IdeaZero/Solar_Ribbit_Pro/Electronics/Design/PCB_Image.png

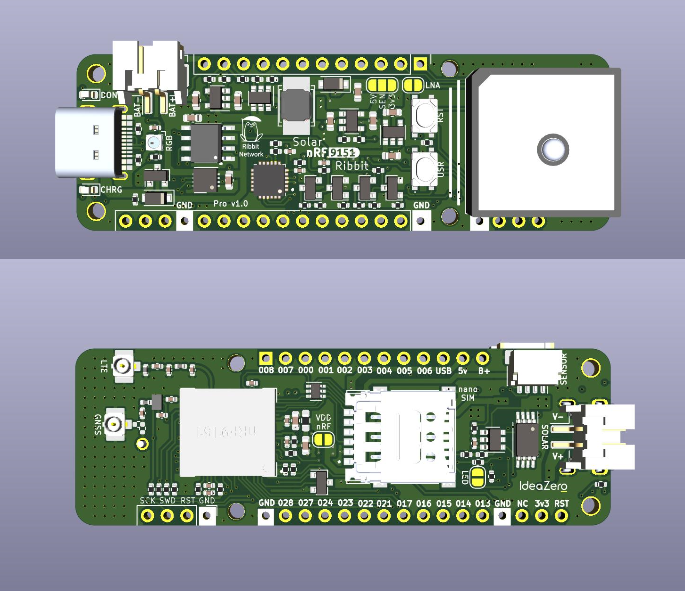
Electronics/Design/PCB_Image.png
