IdeaZero/Solar_Ribbit_Pro/Firmware/hex/Firmware.png

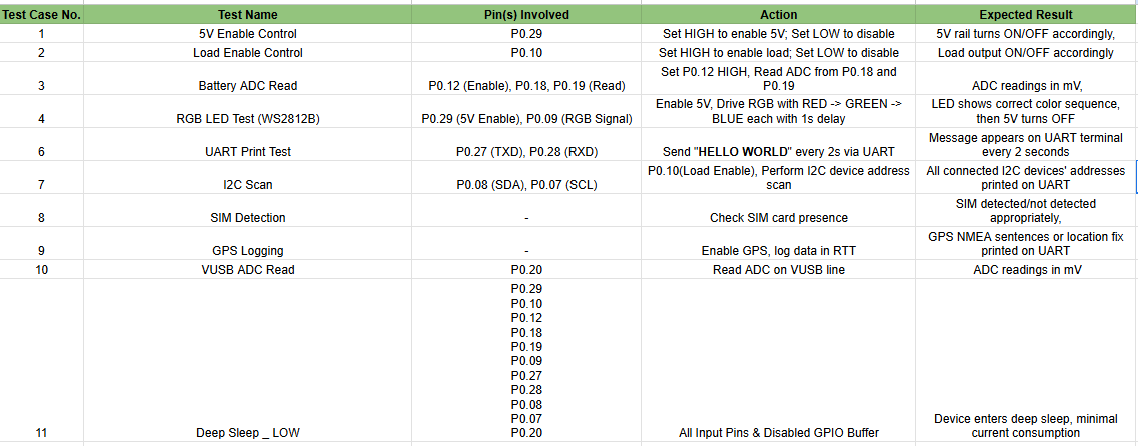
Firmware/hex/Firmware.png
