IdeaZero/Solar_Ribbit_Pro/Electronics/Manufacturing/nRF9151_Linear.kicad_pcb_bom.xlsx

Designator | Quantity | Value | Footprint | MPN | DNP | Mount_Type | Comments
AE1 | 1 | Antenna | YG0005AA | YG0005AA |  | tht
C1, C11, C12, C19, C2, C20, C21, C23, C24, C26, C4 | 11 | 10uF | C_0603_1608Metric | CL10A106MO8NQNC |  | smt
C10, C14, C16, C18, C27, C6, C7 | 7 | 0.1uF | C_0402_1005Metric | CC0402KRX7R7BB104 |  | smt
C13, C9 | 2 | 4.7uF | C_0402_1005Metric | CL05A475MO5NUNC |  | smt
C15, C17 | 2 | NC | C_0402_1005Metric | - | YES | smt
C22 | 1 | 1nF | C_0402_1005Metric | CC0402KRX5R9BB102 |  | smt
C25 | 1 | 3.5pF | C_0402_1005Metric | GRM1555C1H3R5CA01D |  | smt
C3, C5 | 2 | 1uF | C_0402_1005Metric | CL05A105KO5NNNC |  | smt
C8 | 1 | 39pF | C_0402_1005Metric | CC0402JRNPO9BN390 |  | smt
D1, D2 | 2 | SS34 | D_SOD-123F | DSS34 |  | smt
D3 | 1 | DONE | LED_0603_1608Metric | PSC-1608U52GC-G4 |  | smt
D4 | 1 | CHRG | LED_0603_1608Metric | XL-1608SURC-06 |  | smt
D5 | 1 | ESD | SOT-363_SC-70-6 | PSC-1608U52GC-G4 |  | smt
D6 | 1 | RGB | SK6812_2020 | SK6812-EC20 |  | tht
FB1 | 1 | 120R/0.7A | R_0603_1608Metric | FCM1608KF-121T06 |  | smt
IC1 | 1 | BGA524N6E6327XTSA1 | BGA524N6E6327XTSA1 | BGA524N6E6327XTSA1 |  | smt
J1 | 1 | USC-C | USB_TYPE-C-31-M-12_ExtraPad | TYPE-C-31-M-12 |  | tht
J10 | 1 | GPIOXL | PinHeader_1x16_P2.54mm_Vertical | - | YES | tht
J11 | 1 | GPIOXR | PinHeader_1x12_P2.54mm_Vertical | - | YES | tht
J2 | 2 | SOLAR, BAT | JST_PH_B2B-PH-SM4-TB_1x02-1MP_P2.00mm_Vertical | PH-2PWB |  | smt
J4 | 1 | SWD | PinHeader_1x04_P2.54mm_Vertical | - | YES | tht
J5 | 1 | NSIM-2-C | NSIM-2-C | NSIM-2-C |  | smt
J6 | 1 | QWIIC/STEMMA | JST_SH_SM04B-SRSS-TB_1x04-1MP_P1.00mm_Horizontal | 1.0-4PWB |  | smt
J7 | 2 | GNSS, LTE | U.FL-R-SMT-1 | U.FL-R-SMT(10) |  | tht
JP1 | 1 | 5V3 | SolderJumper-3 | - | YES | tht
JP2 | 1 | LED_PWR | SolderJumper-2 | - | YES | tht
JP5 | 1 | VDD_LNA | SolderJumper-2 | - | YES | tht
JP6 | 1 | VDD_nRF | SolderJumper-2 | - | YES | tht
L1 | 1 | 10uH | 5x5 | GPSR0520-100M |  | tht
L2 | 1 | 1.5nH | L_0402_1005Metric | LQG15HS1N5S02D |  | smt
L3 | 1 | 9.1nH | L_0402_1005Metric | LQG15HS9N1J02D |  | smt
L4 | 1 | 22nH | L_0402_1005Metric | LQG15HS22NJ02D |  | smt
Q1, Q3, Q5 | 3 | Si2319CDS | SOT-23 | SI2319CDS |  | smt
Q2, Q4, Q6 | 3 | BSS138 | SOT-23 | BSS138 |  | smt
R1, R13, R14, R26, R29, R31, R34, R40 | 8 | 10K | R_0402_1005Metric | RC0402FR-0710KL |  | smt
R10, R11 | 2 | 5.1K | R_0402_1005Metric | RC0402FR-075K1L |  | smt
R12, R25, R38, R39 | 4 | 1M | R_0402_1005Metric | RC0402FR-071ML |  | smt
R15, R16, R19 | 3 | 1K | R_0402_1005Metric | RC0402FR-071KL |  | smt
R17, R18, R27, R28, R8, R9 | 6 | 0R | R_0402_1005Metric | RC0402JR-070RL |  | smt
R2 | 1 | 22K | R_0402_1005Metric | RC0402FR-0722KL |  | smt
R20, R21, R32, R33 | 4 | 4.7K | R_0402_1005Metric | RC0402FR-074K7L |  | smt
R22, R37 | 2 | 47K | R_0402_1005Metric | RC0402FR-0747KL |  | smt
R23, R35, R36, R4, R5, R7 | 6 | 100K | R_0402_1005Metric | RC0402FR-07100KL |  | smt
R24 | 1 | 13K | R_0402_1005Metric | RC0402FR-0713KL |  | smt
R3 | 1 | 33K | R_0402_1005Metric | RC0402FR-0733KL |  | smt
R41 | 1 | 470R | R_0402_1005Metric | RC0402FR-07470RL |  | smt
R42 | 1 | 100R | R_0402_1005Metric | RC0402FR-07100RL |  | smt
R6 | 1 | 220K | R_0402_1005Metric | RC0402FR-07220KL |  | smt
SW1 | 2 | USER, RESET | SPST_PTS815XX | PTS815SJK250SMTRLFS |  | smt
U1, U10 | 2 | MT9700 | SOT-23-5 | MT9700 |  | smt
U2 | 1 | MT3608L | SOT-23-6 | MT3608L |  | smt
U3 | 1 | CP2102N-A02-GQFN24R | CP2102N-A02-GQFN24R | CP2102N-A02 |  | smt | Optional -- for debugging
U4 | 1 | TP4056_CH | SOP-8 | TP4056 |  | smt
U5 | 1 | CN3165 | DFN-8-1EP_3x3mm_P0.5mm_EP1.66x2.38mm | CN3165 | YES | smt | Optional – Either this or TP4056 – anyone
U6 | 1 | XC6220B331MR-G | SOT-23-5 | XC6220B331MR-G |  | smt
U7 | 1 | DW01_Batt_Protection | SOT-23-6 | DW01 |  | smt
U8 | 1 | FS8205A_Bat_Protection | TSSOP-8_4.4x3mm_P0.65mm | FS8205A |  | smt
U9 | 1 | NRF9151-LACA-R7 | NRF9151-LACA-R7 | NRF9151-LACA-R7 |  | smt
