IdeaZero/Solar_Ribbit_Pro/Mechanical/V4_Holder_3.STL

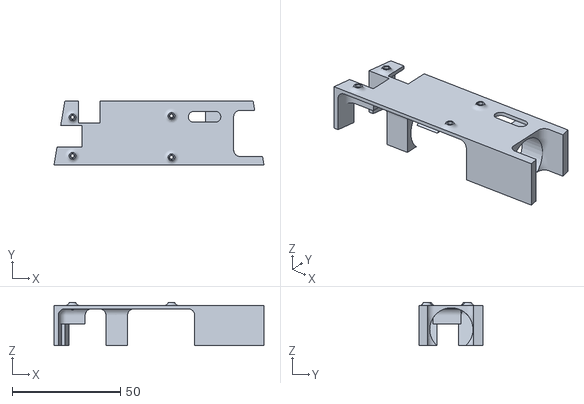
[picture p3: CAD file, 2025-05-09]
Mechanical/V4_Holder_3.STL
97.0 x 29.4 x 20.0
