IdeaZero/Solar_Ribbit_Pro/Firmware/Firmware/led_strip/build/led_strip_sysbuild_cache.txt

APPLICATION_BINARY_DIR:PATH=/home/parth/Desktop/nrf9151/led_strip/build
APPLICATION_SOURCE_DIR:PATH=/home/parth/ncs/v2.8.0/zephyr/share/sysbuild/template
APP_DIR:PATH=/home/parth/Desktop/nrf9151/led_strip
BOARD_DIR:PATH=/home/parth/ncs/v2.8.0/zephyr/boards/nordic/nrf9151dk
BOARD_DIRECTORIES:INTERNAL=/home/parth/ncs/v2.8.0/zephyr/boards/nordic/nrf9151dk
BOARD_EXTENSIONS:BOOL=ON
BOARD_ROOT:PATH=/home/parth/Desktop/nrf9151/led_strip
CACHED_BOARD:STRING=nrf9151dk/nrf9151/ns
CACHED_SHIELD:STRING=
FIND_PACKAGE_MESSAGE_DETAILS_Python3:INTERNAL=[/home/parth/ncs/toolchains/b81a7cd864/usr/local/bin/python3.12][cfound components: Interpreter ][v3.12.4(3.8)]
HWM:INTERNAL=v2
HWMv2:INTERNAL=True
NCS_TOOLCHAIN_VERSION:UNINITIALIZED=NONE
WEST:INTERNAL=/home/parth/ncs/toolchains/b81a7cd864/usr/local/bin/python3.12;-m;west
WEST_PYTHON:UNINITIALIZED=/home/parth/ncs/toolchains/b81a7cd864/usr/local/bin/python3.12
ZEPHYR_BASE:PATH=/home/parth/ncs/v2.8.0/zephyr
ZEPHYR_RUNNER_CONFIG_KERNEL_HEX:STRING=
Zephyr_DIR:PATH=/home/parth/ncs/v2.8.0/zephyr/share/zephyr-package/cmake
_Python3_EXECUTABLE:INTERNAL=/home/parth/ncs/toolchains/b81a7cd864/usr/local/bin/python3.12
_Python3_INTERPRETER_PROPERTIES:INTERNAL=Python;3;12;4;64;;cpython-312-x86_64-linux-gnu;/home/parth/ncs/toolchains/b81a7cd864/usr/local/lib/python3.12;/home/parth/ncs/toolchains/b81a7cd864/usr/local/lib/python3.12;/home/parth/ncs/toolchains/b81a7cd864/usr/local/lib/python3.12/site-packages;/home/parth/ncs/toolchains/b81a7cd864/usr/local/lib/python3.12/site-packages
_Python3_INTERPRETER_SIGNATURE:INTERNAL=3b1ab44936b71dc33967b66e626e99eb
led_strip_NCS_RUNNER_HEX:INTERNAL=/home/parth/Desktop/nrf9151/led_strip/build/merged.hex
sysbuild_BINARY_DIR:STATIC=/home/parth/Desktop/nrf9151/led_strip/build/_sysbuild
sysbuild_IS_TOP_LEVEL:STATIC=OFF
sysbuild_SOURCE_DIR:STATIC=/home/parth/ncs/v2.8.0/zephyr/share/sysbuild/template
sysbuild_toplevel_BINARY_DIR:STATIC=/home/parth/Desktop/nrf9151/led_strip/build
sysbuild_toplevel_IS_TOP_LEVEL:STATIC=ON
sysbuild_toplevel_SOURCE_DIR:STATIC=/home/parth/ncs/v2.8.0/zephyr/share/sysbuild
BOARD:STRING=nrf9151dk/nrf9151/ns
SYSBUILD_NAME:STRING=led_strip
SYSBUILD_MAIN_APP:BOOL=True
