IdeaZero/Solar_Ribbit_Pro/Firmware/Firmware/led_strip/build/led_strip/tfm/install_manifest.txt

/home/parth/Desktop/nrf9151/led_strip/build/led_strip/tfm/api_ns/interface/include/tfm_ioctl_core_api.h
/home/parth/Desktop/nrf9151/led_strip/build/led_strip/tfm/api_ns/interface/src/tfm_ioctl_core_ns_api.c
/home/parth/Desktop/nrf9151/led_strip/build/led_strip/tfm/api_ns/platform/common/core/config_nordic_nrf_spe.cmake
/home/parth/Desktop/nrf9151/led_strip/build/led_strip/tfm/api_ns/platform/ext/driver/Driver_Common.h
/home/parth/Desktop/nrf9151/led_strip/build/led_strip/tfm/api_ns/platform/ext/driver/Driver_Flash.h
/home/parth/Desktop/nrf9151/led_strip/build/led_strip/tfm/api_ns/platform/ext/driver/Driver_USART.h
/home/parth/Desktop/nrf9151/led_strip/build/led_strip/tfm/api_ns/platform/common/core/startup.c
/home/parth/Desktop/nrf9151/led_strip/build/led_strip/tfm/api_ns/platform/common/core/startup_nrf91.c
/home/parth/Desktop/nrf9151/led_strip/build/led_strip/tfm/api_ns/platform/common/core/nrfx_glue.c
/home/parth/Desktop/nrf9151/led_strip/build/led_strip/tfm/api_ns/platform/common/core/pal_plat_test.c
/home/parth/Desktop/nrf9151/led_strip/build/led_strip/tfm/api_ns/platform/common/core/pal_plat_test.h
/home/parth/Desktop/nrf9151/led_strip/build/led_strip/tfm/api_ns/platform/common/core/startup.h
/home/parth/Desktop/nrf9151/led_strip/build/led_strip/tfm/api_ns/platform/common/core/target_cfg.h
/home/parth/Desktop/nrf9151/led_strip/build/led_strip/tfm/api_ns/platform/common/core/nrfx_config.h
/home/parth/Desktop/nrf9151/led_strip/build/led_strip/tfm/api_ns/platform/common/core/CMakeLists.txt
/home/parth/Desktop/nrf9151/led_strip/build/led_strip/tfm/api_ns/platform/common/core/config.cmake
/home/parth/Desktop/nrf9151/led_strip/build/led_strip/tfm/api_ns/platform/common/core/native_drivers/spu.h
/home/parth/Desktop/nrf9151/led_strip/build/led_strip/tfm/api_ns/platform/common/core/native_drivers/mpu_armv8m_drv.h
/home/parth/Desktop/nrf9151/led_strip/build/led_strip/tfm/api_ns/platform/common/core/native_drivers/spu.c
/home/parth/Desktop/nrf9151/led_strip/build/led_strip/tfm/api_ns/platform/common/core/native_drivers/mpu_armv8m_drv.c
/home/parth/Desktop/nrf9151/led_strip/build/led_strip/tfm/api_ns/platform/common/core/cmsis_drivers/Driver_USART.c
/home/parth/Desktop/nrf9151/led_strip/build/led_strip/tfm/api_ns/platform/common/core/cmsis_drivers/Driver_Flash.c
/home/parth/Desktop/nrf9151/led_strip/build/led_strip/tfm/api_ns/platform/common/core/common/nrfx_glue.h
/home/parth/Desktop/nrf9151/led_strip/build/led_strip/tfm/api_ns/platform/common/core/common/cmsis.h
/home/parth/Desktop/nrf9151/led_strip/build/led_strip/tfm/api_ns/platform/common/core/common/tfm_hal_platform_common.h
/home/parth/Desktop/nrf9151/led_strip/build/led_strip/tfm/api_ns/platform/common/core/common/nrf-pinctrl.h
/home/parth/Desktop/nrf9151/led_strip/build/led_strip/tfm/api_ns/platform/common/core/common/nrfx_log.h
/home/parth/Desktop/nrf9151/led_strip/build/led_strip/tfm/api_ns/platform/common/core/nrfx/nrfx.h
/home/parth/Desktop/nrf9151/led_strip/build/led_strip/tfm/api_ns/platform/common/core/services/src/tfm_ioctl_core_s_api.c
/home/parth/Desktop/nrf9151/led_strip/build/led_strip/tfm/api_ns/platform/common/core/services/src/tfm_ioctl_core_ns_api.c
/home/parth/Desktop/nrf9151/led_strip/build/led_strip/tfm/api_ns/platform/common/core/services/src/tfm_platform_hal_ioctl.c
/home/parth/Desktop/nrf9151/led_strip/build/led_strip/tfm/api_ns/platform/common/core/services/include/tfm_ioctl_core_api.h
/home/parth/Desktop/nrf9151/led_strip/build/led_strip/tfm/api_ns/platform/common/core/services/include/tfm_platform_hal_ioctl.h
/home/parth/Desktop/nrf9151/led_strip/build/led_strip/tfm/api_ns/platform/common/core/tests/tfm_tests_config.cmake
/home/parth/Desktop/nrf9151/led_strip/build/led_strip/tfm/api_ns/platform/linker_scripts/tfm_common_ns.ld
/home/parth/Desktop/nrf9151/led_strip/build/led_strip/tfm/api_ns/platform/common/nrf91/nrfx_config_nrf91.h
/home/parth/Desktop/nrf9151/led_strip/build/led_strip/tfm/api_ns/platform/common/nrf91/CMakeLists.txt
/home/parth/Desktop/nrf9151/led_strip/build/led_strip/tfm/api_ns/platform/common/nrf91/config.cmake
/home/parth/Desktop/nrf9151/led_strip/build/led_strip/tfm/api_ns/platform/common/nrf91/tests/psa_arch_tests_config.cmake
/home/parth/Desktop/nrf9151/led_strip/build/led_strip/tfm/api_ns/platform/common/nrf91/partition/region_defs.h
/home/parth/Desktop/nrf9151/led_strip/build/led_strip/tfm/api_ns/platform/common/nrf91/partition/flash_layout.h
/home/parth/Desktop/nrf9151/led_strip/build/led_strip/tfm/api_ns/platform/CMakeLists.txt
/home/parth/Desktop/nrf9151/led_strip/build/led_strip/tfm/api_ns/platform/cpuarch.cmake
/home/parth/Desktop/nrf9151/led_strip/build/led_strip/tfm/api_ns/platform/common/nrf9120/cpuarch.cmake
/home/parth/Desktop/nrf9151/led_strip/build/led_strip/tfm/api_ns/platform/config.cmake
/home/parth/Desktop/nrf9151/led_strip/build/led_strip/tfm/api_ns/platform/../common/config.cmake
/home/parth/Desktop/nrf9151/led_strip/build/led_strip/tfm/api_ns/platform/tests/tfm_tests_config.cmake
/home/parth/Desktop/nrf9151/led_strip/build/led_strip/tfm/api_ns/platform/tests/psa_arch_tests_config.cmake
/home/parth/Desktop/nrf9151/led_strip/build/led_strip/tfm/api_ns/bin/tfm_s.axf
/home/parth/Desktop/nrf9151/led_strip/build/led_strip/tfm/api_ns/bin/tfm_s.bin
/home/parth/Desktop/nrf9151/led_strip/build/led_strip/tfm/api_ns/bin/tfm_s.elf
/home/parth/Desktop/nrf9151/led_strip/build/led_strip/tfm/api_ns/bin/tfm_s.map
/home/parth/Desktop/nrf9151/led_strip/build/led_strip/tfm/api_ns/bin/tfm_s.hex
/home/parth/Desktop/nrf9151/led_strip/build/led_strip/tfm/api_ns/interface/lib/s_veneers.o
/home/parth/Desktop/nrf9151/led_strip/build/led_strip/tfm/api_ns/interface/include/psa/client.h
/home/parth/Desktop/nrf9151/led_strip/build/led_strip/tfm/api_ns/interface/include/psa/error.h
/home/parth/Desktop/nrf9151/led_strip/build/led_strip/tfm/api_ns/interface/include/psa_manifest/sid.h
/home/parth/Desktop/nrf9151/led_strip/build/led_strip/tfm/api_ns/interface/include/config_impl.h
/home/parth/Desktop/nrf9151/led_strip/build/led_strip/tfm/api_ns/interface/include/tfm_veneers.h
/home/parth/Desktop/nrf9151/led_strip/build/led_strip/tfm/api_ns/interface/include/tfm_ns_interface.h
/home/parth/Desktop/nrf9151/led_strip/build/led_strip/tfm/api_ns/interface/include/tfm_ns_client_ext.h
/home/parth/Desktop/nrf9151/led_strip/build/led_strip/tfm/api_ns/interface/include/config_tfm.h
/home/parth/Desktop/nrf9151/led_strip/build/led_strip/tfm/api_ns/interface/include/config_base.h
/home/parth/Desktop/nrf9151/led_strip/build/led_strip/tfm/api_ns/interface/include/tfm_psa_call_pack.h
/home/parth/Desktop/nrf9151/led_strip/build/led_strip/tfm/api_ns/interface/include/psa/framework_feature.h
/home/parth/Desktop/nrf9151/led_strip/build/led_strip/tfm/api_ns/interface/include/psa/build_info.h
/home/parth/Desktop/nrf9151/led_strip/build/led_strip/tfm/api_ns/interface/include/psa/crypto_adjust_auto_enabled.h
/home/parth/Desktop/nrf9151/led_strip/build/led_strip/tfm/api_ns/interface/include/psa/crypto_adjust_config_key_pair_types.h
/home/parth/Desktop/nrf9151/led_strip/build/led_strip/tfm/api_ns/interface/include/psa/crypto_adjust_config_synonyms.h
/home/parth/Desktop/nrf9151/led_strip/build/led_strip/tfm/api_ns/interface/include/psa/crypto_compat.h
/home/parth/Desktop/nrf9151/led_strip/build/led_strip/tfm/api_ns/interface/include/psa/crypto_driver_common.h
/home/parth/Desktop/nrf9151/led_strip/build/led_strip/tfm/api_ns/interface/include/psa/crypto_driver_contexts_composites.h
/home/parth/Desktop/nrf9151/led_strip/build/led_strip/tfm/api_ns/interface/include/psa/crypto_driver_contexts_key_derivation.h
/home/parth/Desktop/nrf9151/led_strip/build/led_strip/tfm/api_ns/interface/include/psa/crypto_driver_contexts_primitives.h
/home/parth/Desktop/nrf9151/led_strip/build/led_strip/tfm/api_ns/interface/include/psa/crypto_extra.h
/home/parth/Desktop/nrf9151/led_strip/build/led_strip/tfm/api_ns/interface/include/psa/crypto_legacy.h
/home/parth/Desktop/nrf9151/led_strip/build/led_strip/tfm/api_ns/interface/include/psa/crypto_platform.h
/home/parth/Desktop/nrf9151/led_strip/build/led_strip/tfm/api_ns/interface/include/psa/crypto_se_driver.h
/home/parth/Desktop/nrf9151/led_strip/build/led_strip/tfm/api_ns/interface/include/psa/crypto_sizes.h
/home/parth/Desktop/nrf9151/led_strip/build/led_strip/tfm/api_ns/interface/include/psa/crypto_struct.h
/home/parth/Desktop/nrf9151/led_strip/build/led_strip/tfm/api_ns/interface/include/psa/crypto_types.h
/home/parth/Desktop/nrf9151/led_strip/build/led_strip/tfm/api_ns/interface/include/psa/crypto_values.h
/home/parth/Desktop/nrf9151/led_strip/build/led_strip/tfm/api_ns/interface/include/psa/crypto.h
/home/parth/Desktop/nrf9151/led_strip/build/led_strip/tfm/api_ns/interface/include/mbedtls/build_info.h
/home/parth/Desktop/nrf9151/led_strip/build/led_strip/tfm/api_ns/interface/include/mbedtls/config_psa.h
/home/parth/Desktop/nrf9151/led_strip/build/led_strip/tfm/api_ns/interface/include/nrf-config.h
/home/parth/Desktop/nrf9151/led_strip/build/led_strip/tfm/api_ns/interface/include/nrf-psa-crypto-config.h
/home/parth/Desktop/nrf9151/led_strip/build/led_strip/tfm/api_ns/interface/include/tfm_platform_api.h
/home/parth/Desktop/nrf9151/led_strip/build/led_strip/tfm/api_ns/interface/src/tfm_tz_psa_ns_api.c
/home/parth/Desktop/nrf9151/led_strip/build/led_strip/tfm/api_ns/interface/include/os_wrapper/common.h
/home/parth/Desktop/nrf9151/led_strip/build/led_strip/tfm/api_ns/interface/include/os_wrapper/mutex.h
/home/parth/Desktop/nrf9151/led_strip/build/led_strip/tfm/api_ns/interface/src/os_wrapper/tfm_ns_interface_rtos.c
/home/parth/Desktop/nrf9151/led_strip/build/led_strip/tfm/api_ns/interface/src/os_wrapper/tfm_ns_interface_bare_metal.c
/home/parth/Desktop/nrf9151/led_strip/build/led_strip/tfm/api_ns/interface/src/tfm_crypto_api.c
/home/parth/Desktop/nrf9151/led_strip/build/led_strip/tfm/api_ns/interface/src/tfm_platform_api.c
/home/parth/Desktop/nrf9151/led_strip/build/led_strip/tfm/api_ns/config/cp_check.cmake
/home/parth/Desktop/nrf9151/led_strip/build/led_strip/tfm/api_ns/platform/ext/cmsis/Include/core_cm3.h
/home/parth/Desktop/nrf9151/led_strip/build/led_strip/tfm/api_ns/platform/ext/cmsis/Include/core_cm4.h
/home/parth/Desktop/nrf9151/led_strip/build/led_strip/tfm/api_ns/platform/ext/cmsis/Include/core_cm7.h
/home/parth/Desktop/nrf9151/led_strip/build/led_strip/tfm/api_ns/platform/ext/cmsis/Include/core_ca.h
/home/parth/Desktop/nrf9151/led_strip/build/led_strip/tfm/api_ns/platform/ext/cmsis/Include/core_cm1.h
/home/parth/Desktop/nrf9151/led_strip/build/led_strip/tfm/api_ns/platform/ext/cmsis/Include/core_cm35p.h
/home/parth/Desktop/nrf9151/led_strip/build/led_strip/tfm/api_ns/platform/ext/cmsis/Include/a-profile/cmsis_armclang_a.h
/home/parth/Desktop/nrf9151/led_strip/build/led_strip/tfm/api_ns/platform/ext/cmsis/Include/a-profile/cmsis_cp15.h
/home/parth/Desktop/nrf9151/led_strip/build/led_strip/tfm/api_ns/platform/ext/cmsis/Include/a-profile/cmsis_clang_a.h
/home/parth/Desktop/nrf9151/led_strip/build/led_strip/tfm/api_ns/platform/ext/cmsis/Include/a-profile/irq_ctrl.h
/home/parth/Desktop/nrf9151/led_strip/build/led_strip/tfm/api_ns/platform/ext/cmsis/Include/a-profile/cmsis_gcc_a.h
/home/parth/Desktop/nrf9151/led_strip/build/led_strip/tfm/api_ns/platform/ext/cmsis/Include/a-profile/cmsis_iccarm_a.h
/home/parth/Desktop/nrf9151/led_strip/build/led_strip/tfm/api_ns/platform/ext/cmsis/Include/cmsis_version.h
/home/parth/Desktop/nrf9151/led_strip/build/led_strip/tfm/api_ns/platform/ext/cmsis/Include/core_cm0.h
/home/parth/Desktop/nrf9151/led_strip/build/led_strip/tfm/api_ns/platform/ext/cmsis/Include/core_cm85.h
/home/parth/Desktop/nrf9151/led_strip/build/led_strip/tfm/api_ns/platform/ext/cmsis/Include/core_cm0plus.h
/home/parth/Desktop/nrf9151/led_strip/build/led_strip/tfm/api_ns/platform/ext/cmsis/Include/tz_context.h
/home/parth/Desktop/nrf9151/led_strip/build/led_strip/tfm/api_ns/platform/ext/cmsis/Include/core_cm23.h
/home/parth/Desktop/nrf9151/led_strip/build/led_strip/tfm/api_ns/platform/ext/cmsis/Include/core_sc300.h
/home/parth/Desktop/nrf9151/led_strip/build/led_strip/tfm/api_ns/platform/ext/cmsis/Include/core_sc000.h
/home/parth/Desktop/nrf9151/led_strip/build/led_strip/tfm/api_ns/platform/ext/cmsis/Include/core_cm55.h
/home/parth/Desktop/nrf9151/led_strip/build/led_strip/tfm/api_ns/platform/ext/cmsis/Include/cmsis_compiler.h
/home/parth/Desktop/nrf9151/led_strip/build/led_strip/tfm/api_ns/platform/ext/cmsis/Include/m-profile/armv7m_cachel1.h
/home/parth/Desktop/nrf9151/led_strip/build/led_strip/tfm/api_ns/platform/ext/cmsis/Include/m-profile/cmsis_tiarmclang_m.h
/home/parth/Desktop/nrf9151/led_strip/build/led_strip/tfm/api_ns/platform/ext/cmsis/Include/m-profile/armv7m_mpu.h
/home/parth/Desktop/nrf9151/led_strip/build/led_strip/tfm/api_ns/platform/ext/cmsis/Include/m-profile/armv81m_pac.h
/home/parth/Desktop/nrf9151/led_strip/build/led_strip/tfm/api_ns/platform/ext/cmsis/Include/m-profile/armv8m_pmu.h
/home/parth/Desktop/nrf9151/led_strip/build/led_strip/tfm/api_ns/platform/ext/cmsis/Include/m-profile/cmsis_iccarm_m.h
/home/parth/Desktop/nrf9151/led_strip/build/led_strip/tfm/api_ns/platform/ext/cmsis/Include/m-profile/armv8m_mpu.h
/home/parth/Desktop/nrf9151/led_strip/build/led_strip/tfm/api_ns/platform/ext/cmsis/Include/m-profile/cmsis_clang_m.h
/home/parth/Desktop/nrf9151/led_strip/build/led_strip/tfm/api_ns/platform/ext/cmsis/Include/m-profile/cmsis_armclang_m.h
/home/parth/Desktop/nrf9151/led_strip/build/led_strip/tfm/api_ns/platform/ext/cmsis/Include/m-profile/cmsis_gcc_m.h
/home/parth/Desktop/nrf9151/led_strip/build/led_strip/tfm/api_ns/platform/ext/cmsis/Include/core_starmc1.h
/home/parth/Desktop/nrf9151/led_strip/build/led_strip/tfm/api_ns/platform/ext/cmsis/Include/core_cm33.h
/home/parth/Desktop/nrf9151/led_strip/build/led_strip/tfm/api_ns/platform/ext/cmsis/Include/core_cm52.h
/home/parth/Desktop/nrf9151/led_strip/build/led_strip/tfm/api_ns/platform/ext/common/uart_stdout.c
/home/parth/Desktop/nrf9151/led_strip/build/led_strip/tfm/api_ns/platform/ext/common/uart_stdout.h
/home/parth/Desktop/nrf9151/led_strip/build/led_strip/tfm/api_ns/platform/include/tfm_plat_ns.h
/home/parth/Desktop/nrf9151/led_strip/build/led_strip/tfm/api_ns/platform/include/tfm_hal_mailbox.h
/home/parth/Desktop/nrf9151/led_strip/build/led_strip/tfm/api_ns/platform/include/tfm_platform_system.h
/home/parth/Desktop/nrf9151/led_strip/build/led_strip/tfm/api_ns/platform/include/tfm_hal_its.h
/home/parth/Desktop/nrf9151/led_strip/build/led_strip/tfm/api_ns/platform/include/fatal_error.h
/home/parth/Desktop/nrf9151/led_strip/build/led_strip/tfm/api_ns/platform/include/tfm_hal_isolation.h
/home/parth/Desktop/nrf9151/led_strip/build/led_strip/tfm/api_ns/platform/include/tfm_plat_otp.h
/home/parth/Desktop/nrf9151/led_strip/build/led_strip/tfm/api_ns/platform/include/tfm_attest_hal.h
/home/parth/Desktop/nrf9151/led_strip/build/led_strip/tfm/api_ns/platform/include/tfm_plat_config.h
/home/parth/Desktop/nrf9151/led_strip/build/led_strip/tfm/api_ns/platform/include/tfm_plat_provisioning.h
/home/parth/Desktop/nrf9151/led_strip/build/led_strip/tfm/api_ns/platform/include/boot_hal.h
/home/parth/Desktop/nrf9151/led_strip/build/led_strip/tfm/api_ns/platform/include/tfm_hal_multi_core.h
/home/parth/Desktop/nrf9151/led_strip/build/led_strip/tfm/api_ns/platform/include/tfm_hal_ps.h
/home/parth/Desktop/nrf9151/led_strip/build/led_strip/tfm/api_ns/platform/include/tfm_plat_device_id.h
/home/parth/Desktop/nrf9151/led_strip/build/led_strip/tfm/api_ns/platform/include/region.h
/home/parth/Desktop/nrf9151/led_strip/build/led_strip/tfm/api_ns/platform/include/tfm_hal_device_header.h
/home/parth/Desktop/nrf9151/led_strip/build/led_strip/tfm/api_ns/platform/include/tfm_plat_crypto_nv_seed.h
/home/parth/Desktop/nrf9151/led_strip/build/led_strip/tfm/api_ns/platform/include/mbedtls_entropy_nv_seed_config.h
/home/parth/Desktop/nrf9151/led_strip/build/led_strip/tfm/api_ns/platform/include/tfm_hal_defs.h
/home/parth/Desktop/nrf9151/led_strip/build/led_strip/tfm/api_ns/platform/include/tfm_plat_test.h
/home/parth/Desktop/nrf9151/led_strip/build/led_strip/tfm/api_ns/platform/include/tfm_plat_defs.h
/home/parth/Desktop/nrf9151/led_strip/build/led_strip/tfm/api_ns/platform/include/tfm_hal_platform.h
/home/parth/Desktop/nrf9151/led_strip/build/led_strip/tfm/api_ns/platform/include/tfm_hal_its_encryption.h
/home/parth/Desktop/nrf9151/led_strip/build/led_strip/tfm/api_ns/platform/include/tfm_plat_nv_counters.h
/home/parth/Desktop/nrf9151/led_strip/build/led_strip/tfm/api_ns/platform/include/tfm_plat_rotpk.h
/home/parth/Desktop/nrf9151/led_strip/build/led_strip/tfm/api_ns/platform/include/exception_info.h
/home/parth/Desktop/nrf9151/led_strip/build/led_strip/tfm/api_ns/platform/include/tfm_plat_crypto_keys.h
/home/parth/Desktop/nrf9151/led_strip/build/led_strip/tfm/api_ns/platform/include/tfm_hal_interrupt.h
/home/parth/Desktop/nrf9151/led_strip/build/led_strip/tfm/api_ns/platform/include/cmsis_override.h
/home/parth/Desktop/nrf9151/led_strip/build/led_strip/tfm/api_ns/platform/include/tfm_plat_boot_seed.h
/home/parth/Desktop/nrf9151/led_strip/build/led_strip/tfm/api_ns/CMakeLists.txt
/home/parth/Desktop/nrf9151/led_strip/build/led_strip/tfm/api_ns/cmake/toolchain_ns_GNUARM.cmake
/home/parth/Desktop/nrf9151/led_strip/build/led_strip/tfm/api_ns/cmake/toolchain_ns_ARMCLANG.cmake
/home/parth/Desktop/nrf9151/led_strip/build/led_strip/tfm/api_ns/cmake/toolchain_ns_IARARM.cmake
/home/parth/Desktop/nrf9151/led_strip/build/led_strip/tfm/api_ns/platform/include/fih.h
/home/parth/Desktop/nrf9151/led_strip/build/led_strip/tfm/api_ns/platform/include/tfm_plat_ns.h
/home/parth/Desktop/nrf9151/led_strip/build/led_strip/tfm/api_ns/cmake/spe_export.cmake
/home/parth/Desktop/nrf9151/led_strip/build/led_strip/tfm/api_ns/cmake/set_extensions.cmake
