IdeaZero/Solar_Ribbit_Pro/Electronics/Design/Solar_Ribbit_Schematics.pdf

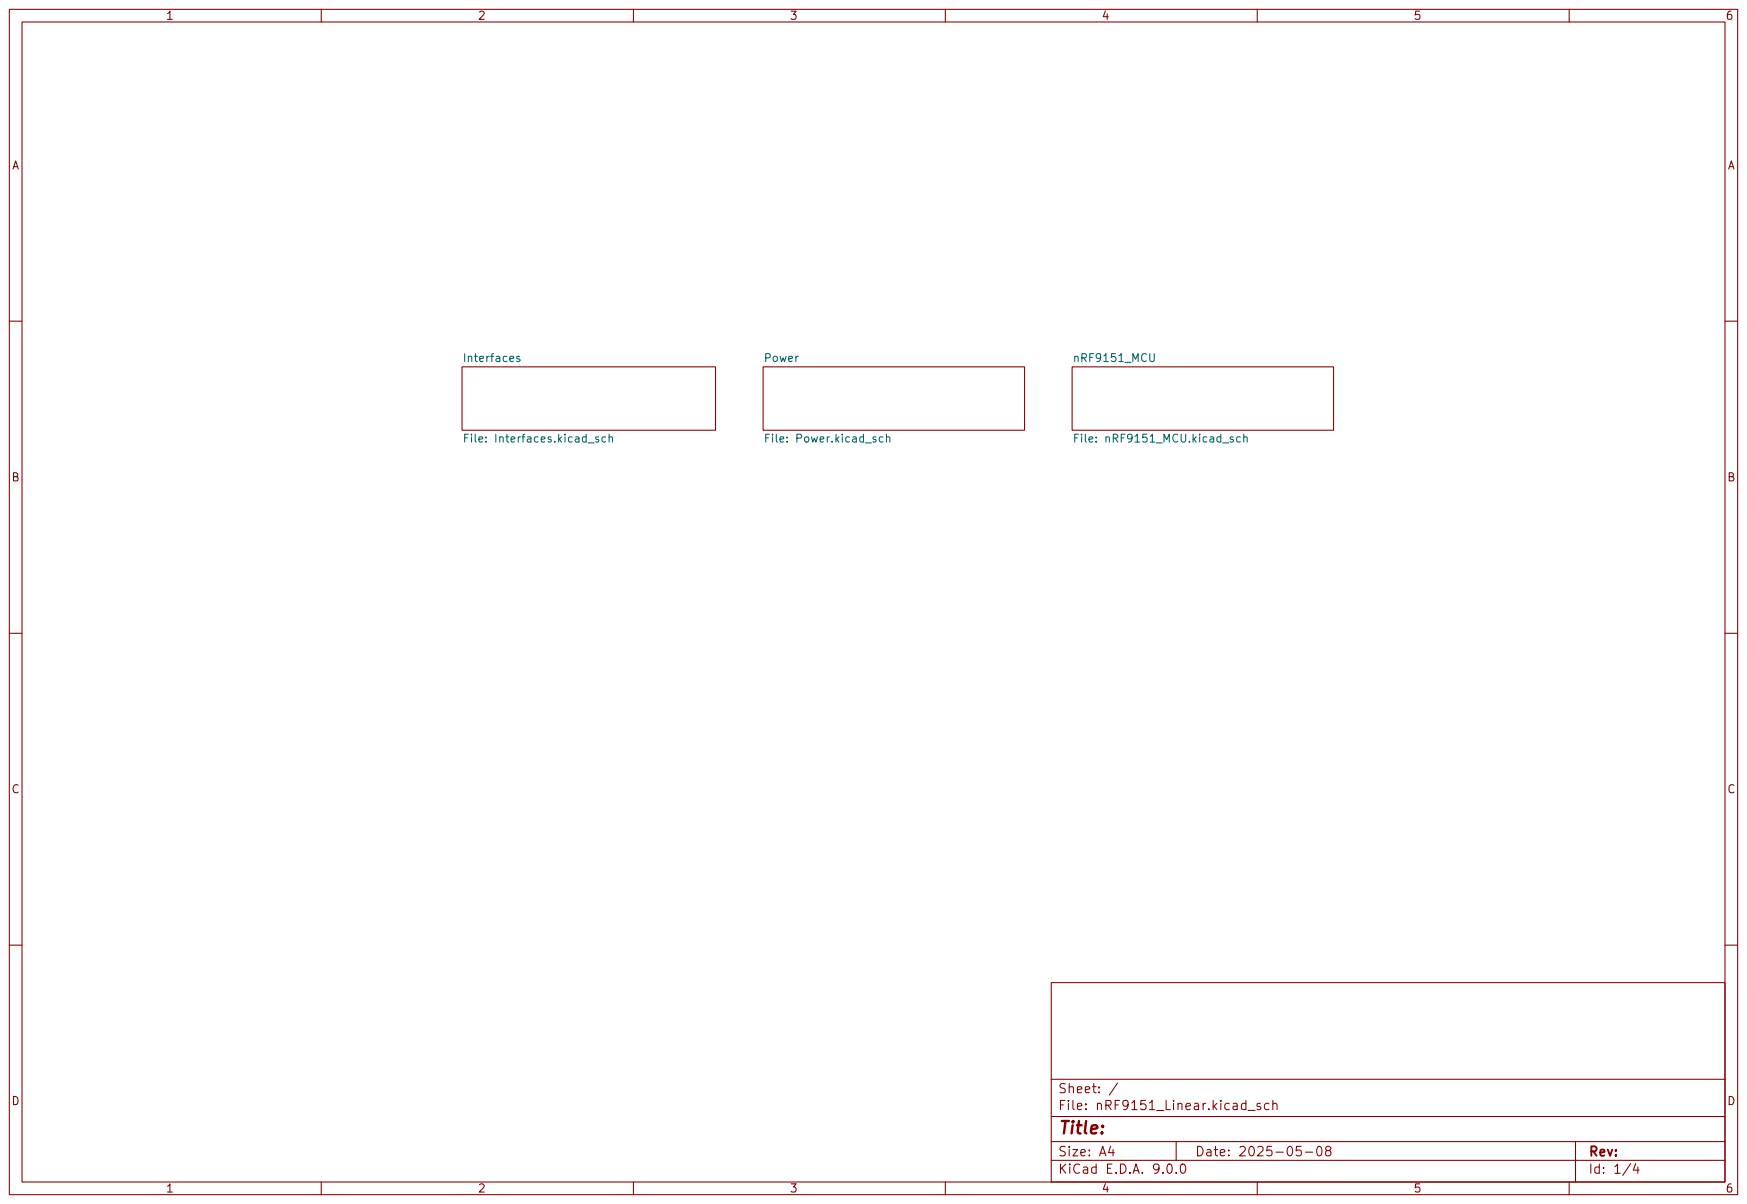
[picture p13: page 1]

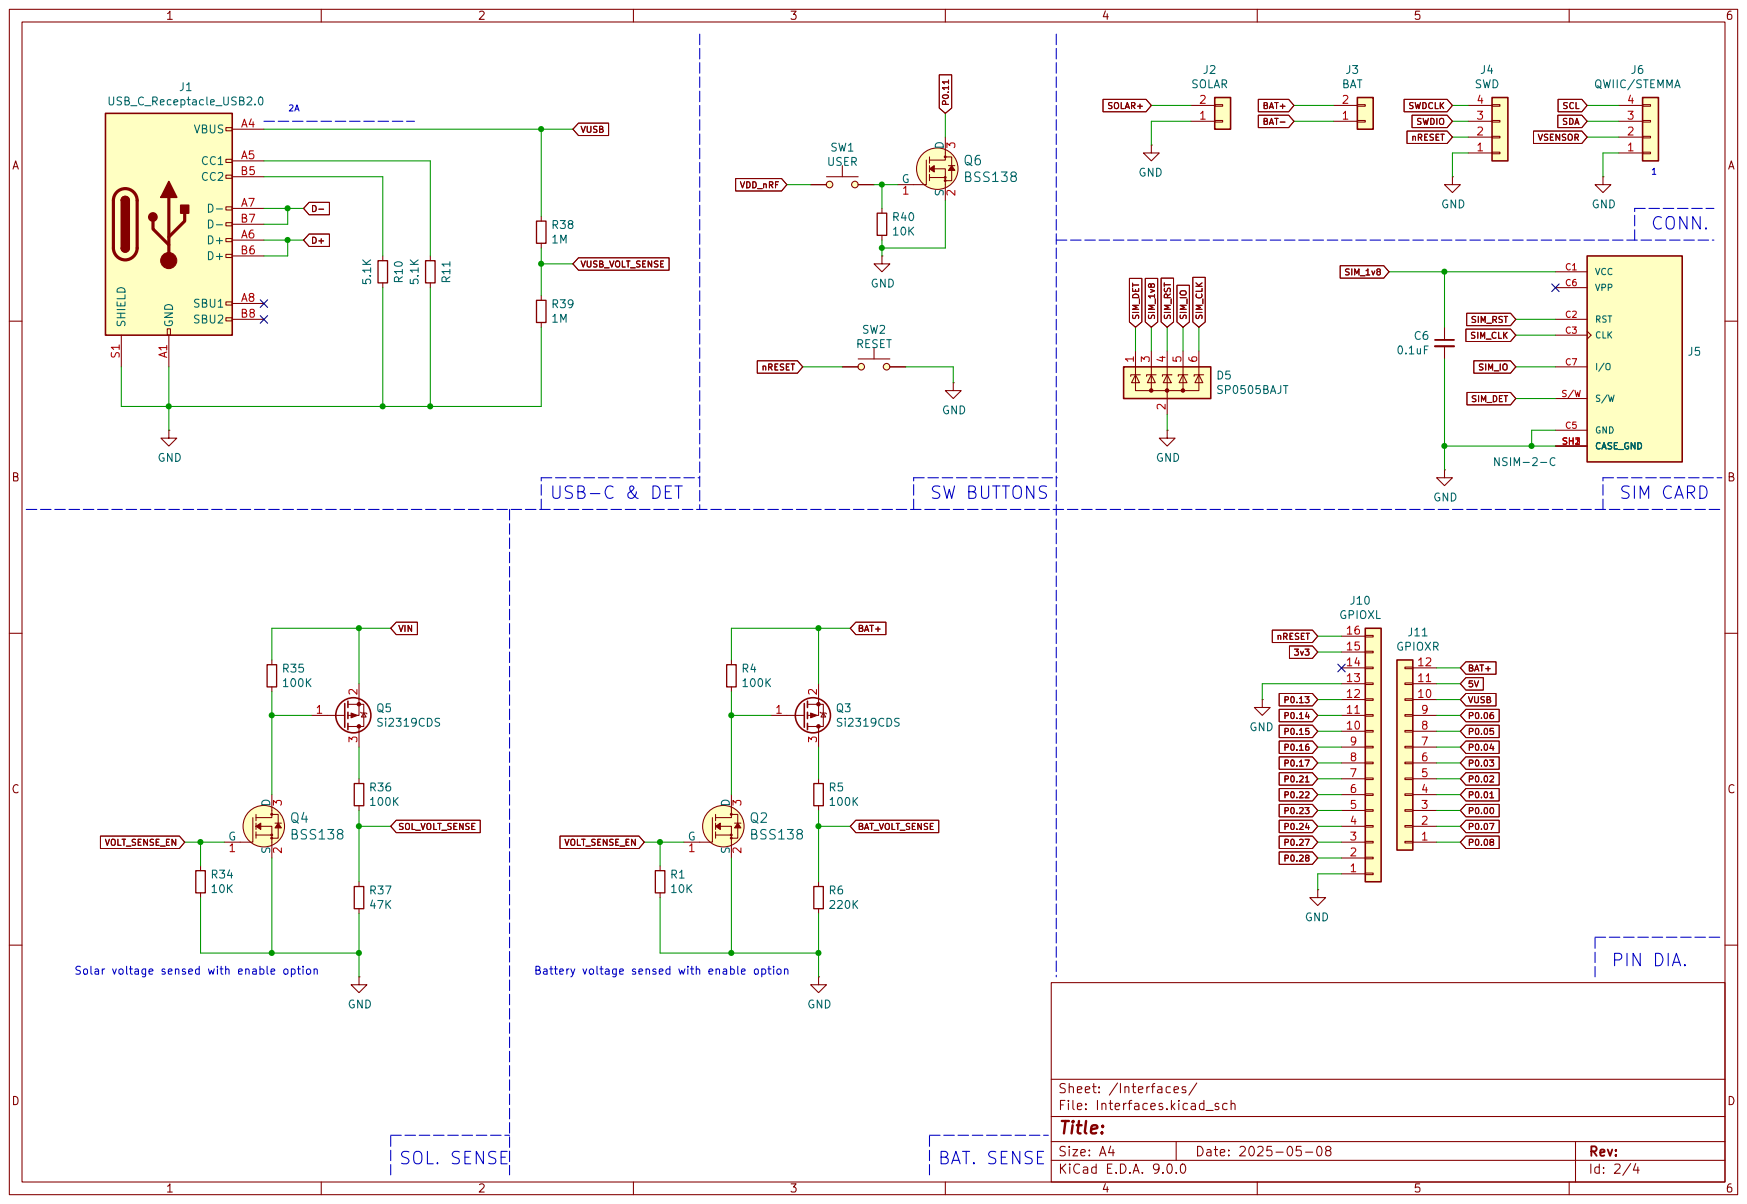
[picture p14: page 2]

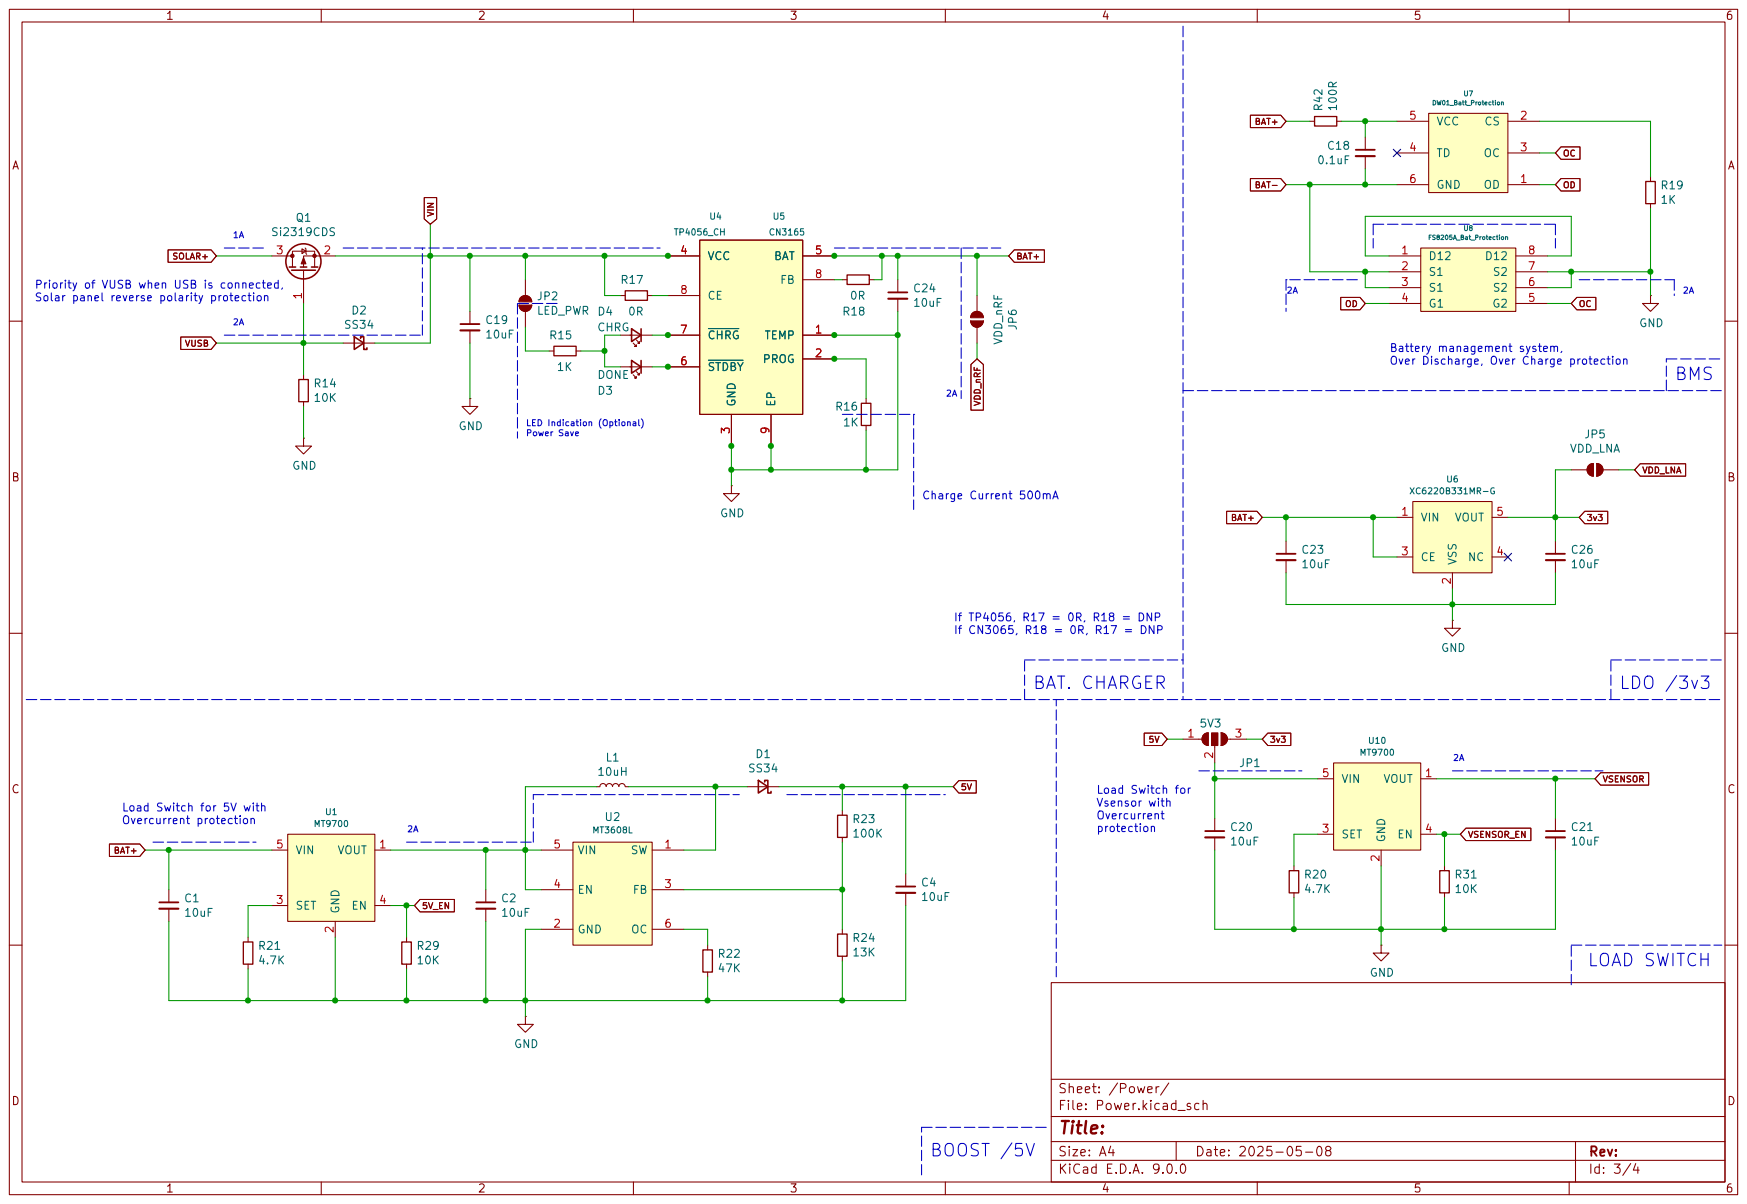
[picture p15: page 3]

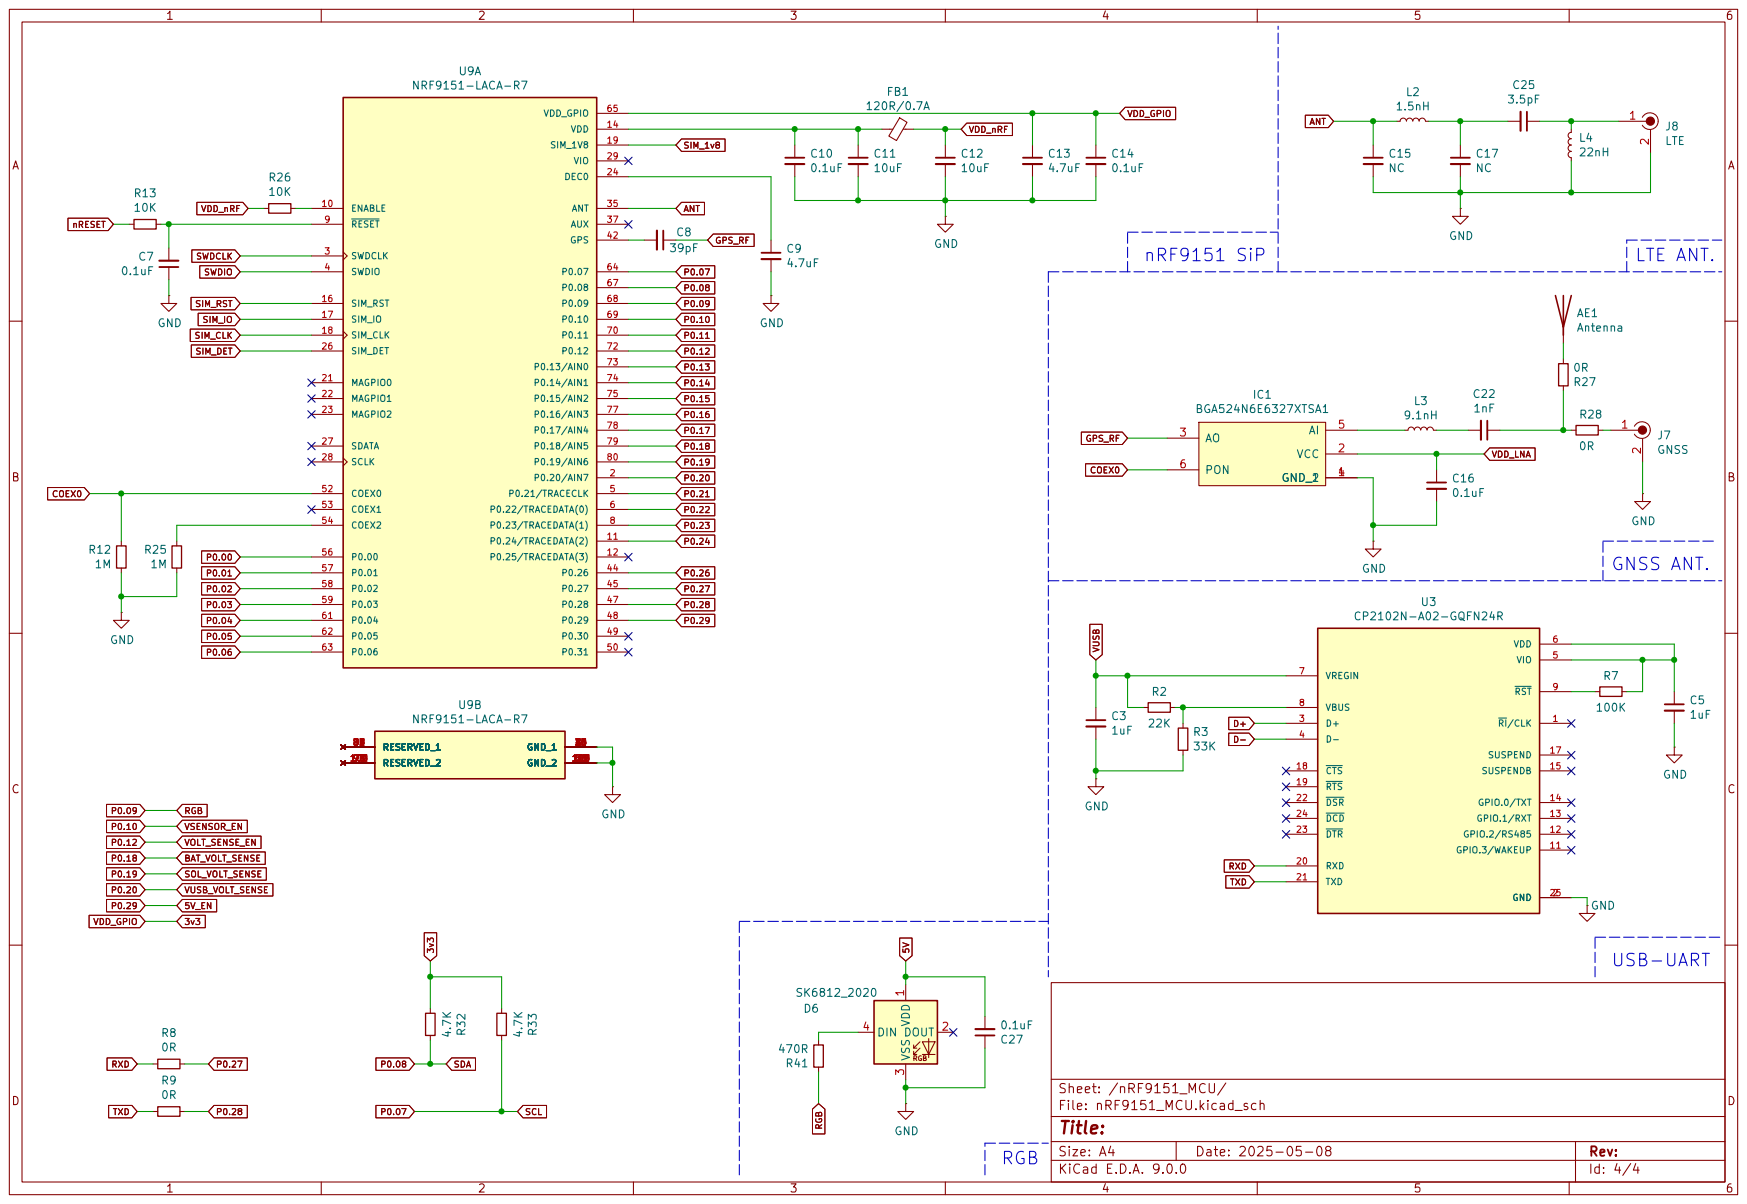
[picture p16: page 4]
