IdeaZero/Solar_Ribbit_Pro/Electronics/Design/nRF9151_Linear.kicad_pcb

## KiCad design Electronics/Design/nRF9151_Linear.kicad_pcb (2025-05-09)

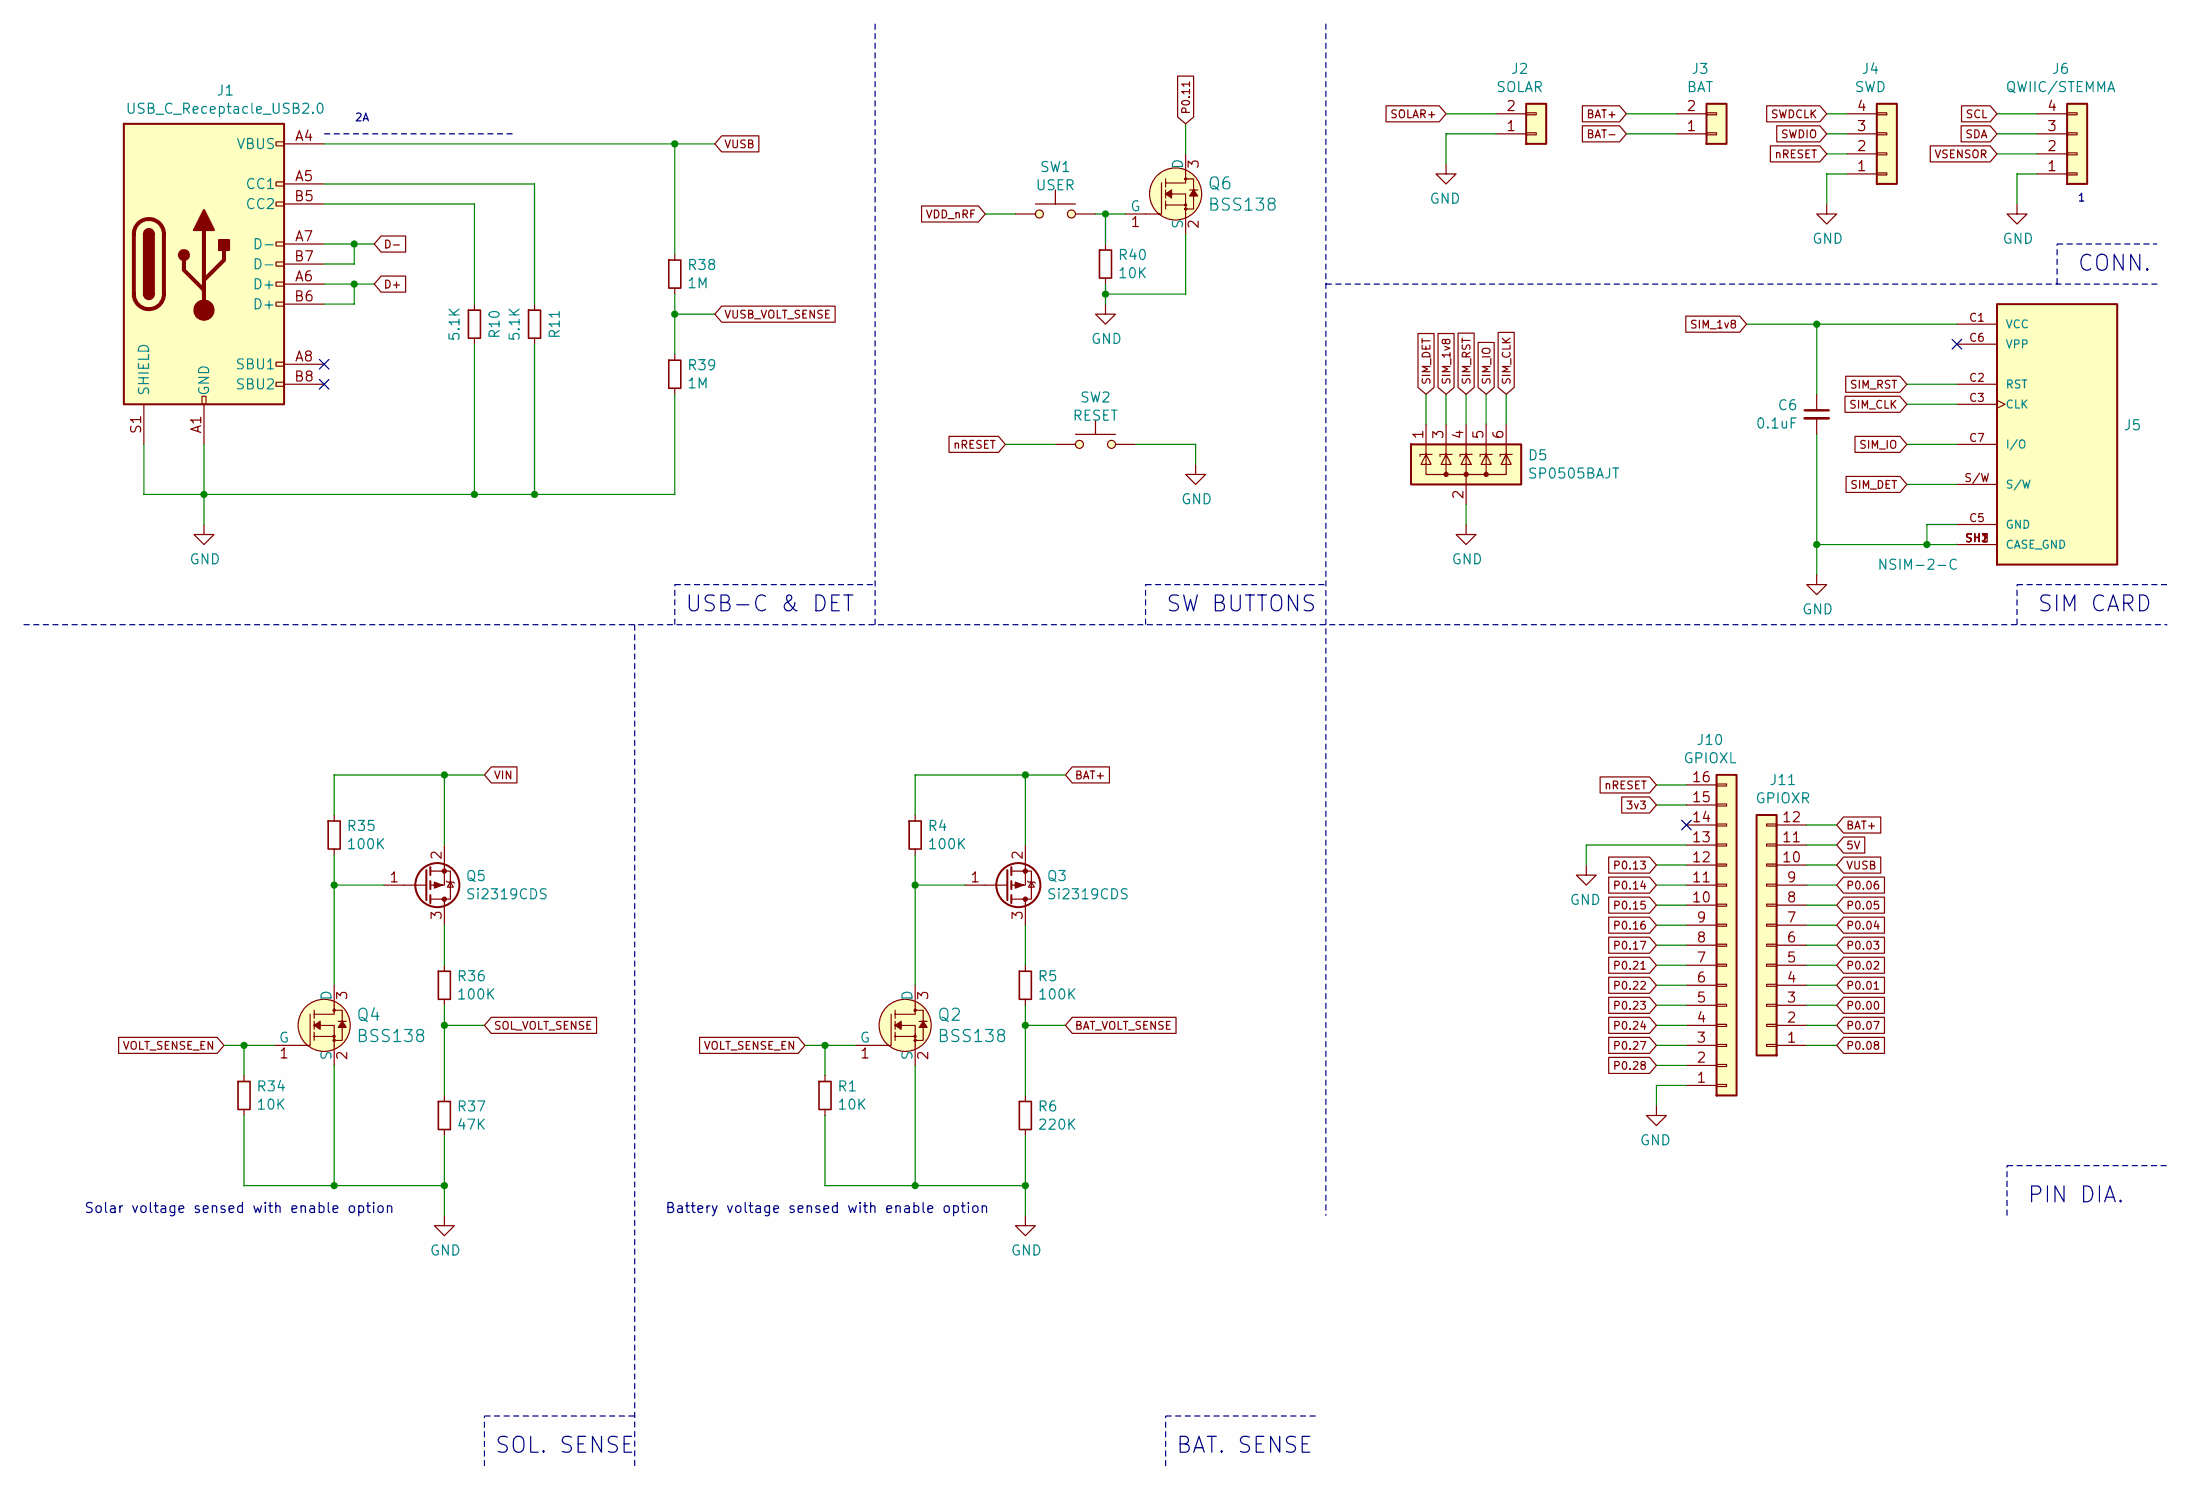
[picture p17: schematic Interfaces.kicad_sch]

Parts:
C6: 0.1uF; C_0402_1005Metric
D5: SP0505BAJT; SOT-363_SC-70-6
J1: USB_C_Receptacle_USB2.0; USB_TYPE-C-31-M-12_ExtraPad
J2: SOLAR; JST_PH_B2B-PH-SM4-TB_1x02-1MP_P2.00mm_Vertical
J3: BAT; JST_PH_B2B-PH-SM4-TB_1x02-1MP_P2.00mm_Vertical
J4: SWD; PinHeader_1x04_P2.54mm_Vertical
J5: NSIM-2-C; PARTREV 1.0
J6: QWIIC/STEMMA; JST_SH_SM04B-SRSS-TB_1x04-1MP_P1.00mm_Horizontal
J10: GPIOXL; PinHeader_1x16_P2.54mm_Vertical
J11: GPIOXR; PinHeader_1x12_P2.54mm_Vertical
Q2, Q4, Q6: BSS138; SOT-23; MPN BSS138; Digi-Key_PN BSS138CT-ND
Q3, Q5: Si2319CDS; SOT-23
R1, R34, R40: 10K; R_0402_1005Metric
R4, R5, R35, R36: 100K; R_0402_1005Metric
R6: 220K; R_0402_1005Metric
R10, R11: 5.1K; R_0402_1005Metric
R37: 47K; R_0402_1005Metric
R38, R39: 1M; R_0402_1005Metric
SW1: USER; SPST_PTS815XX
SW2: RESET; SPST_PTS815XX

Connections:
3v3: J10.15; also elsewhere on the board
5V: J11.11; also elsewhere on the board
BAT+: J3.2, J11.12, Q3.2 (S), R4.1; also elsewhere on the board
BAT-: J3.1; also elsewhere on the board
BAT_VOLT_SENSE: R5.2, R6.1; also elsewhere on the board
D+: J1.A6 (D+), J1.B6 (D+); also elsewhere on the board
D-: J1.A7 (D-), J1.B7 (D-); also elsewhere on the board
GND: C6.2, D5.2 (A), J1.A1 (GND), J1.A12 (GND), J1.B1 (GND), J1.B12 (GND), J1.S1 (SHIELD), J2.1, J4.1, J5.C5 (GND), J5.SH1 (CASE_GND), J5.SH2 (CASE_GND), J5.SH3 (CASE_GND), J6.1, J10.1, J10.13, Q2.2 (S), Q4.2 (S), Q6.2 (S), R1.2, R6.2, R10.2, R11.2, R34.2, R37.2, R39.2, R40.2, SW2.3, SW2.4; also elsewhere on the board
unnamed: J1.A5 (CC1), R11.1
unnamed: J1.B5 (CC2), R10.1
unnamed: Q2.3 (D), Q3.1 (G), R4.2
unnamed: Q3.3 (D), R5.1
unnamed: Q4.3 (D), Q5.1 (G), R35.2
unnamed: Q5.3 (D), R36.1
unnamed: Q6.1 (G), R40.1, SW1.3, SW1.4
P0.00: J11.3; also elsewhere on the board
P0.01: J11.4; also elsewhere on the board
P0.02: J11.5; also elsewhere on the board
P0.03: J11.6; also elsewhere on the board
P0.04: J11.7; also elsewhere on the board
P0.05: J11.8; also elsewhere on the board
P0.06: J11.9; also elsewhere on the board
P0.07: J6.4, J11.2; also elsewhere on the board
P0.08: J6.3, J11.1; also elsewhere on the board
P0.11: Q6.3 (D); also elsewhere on the board
P0.12: Q2.1 (G), Q4.1 (G), R1.1, R34.1; also elsewhere on the board
P0.13: J10.12; also elsewhere on the board
P0.14: J10.11; also elsewhere on the board
P0.15: J10.10; also elsewhere on the board
P0.16: J10.9; also elsewhere on the board
P0.17: J10.8; also elsewhere on the board
P0.19: R36.2, R37.1; also elsewhere on the board
P0.20: R38.2, R39.1; also elsewhere on the board
P0.21: J10.7; also elsewhere on the board
P0.22: J10.6; also elsewhere on the board
P0.23: J10.5; also elsewhere on the board
P0.24: J10.4; also elsewhere on the board
P0.27: J10.3; also elsewhere on the board
P0.28: J10.2; also elsewhere on the board
SIM_1v8: C6.1, D5.3 (K), J5.C1 (VCC); also elsewhere on the board
SIM_CLK: D5.6 (K), J5.C3 (CLK); also elsewhere on the board
SIM_DET: D5.1 (K), J5.S/W; also elsewhere on the board
SIM_IO: D5.5 (K), J5.C7 (I/O); also elsewhere on the board
SIM_RST: D5.4 (K), J5.C2 (RST); also elsewhere on the board
SOLAR+: J2.2; also elsewhere on the board
SWDCLK: J4.4; also elsewhere on the board
SWDIO: J4.3; also elsewhere on the board
VDD_nRF: SW1.1, SW1.2; also elsewhere on the board
VIN: Q5.2 (S), R35.1; also elsewhere on the board
VSENSOR: J6.2; also elsewhere on the board
VUSB: J1.A4 (VBUS), J1.A9 (VBUS), J1.B4 (VBUS), J1.B9 (VBUS), J11.10, R38.1; also elsewhere on the board
nRESET: J4.2, J10.16, SW2.1, SW2.2; also elsewhere on the board

Notes on the sheet:
BAT. SENSE
CONN.
SIM CARD
PIN DIA.
Solar voltage sensed with enable option
USB-C & DET
SOL. SENSE
Battery voltage sensed with enable option
SW BUTTONS

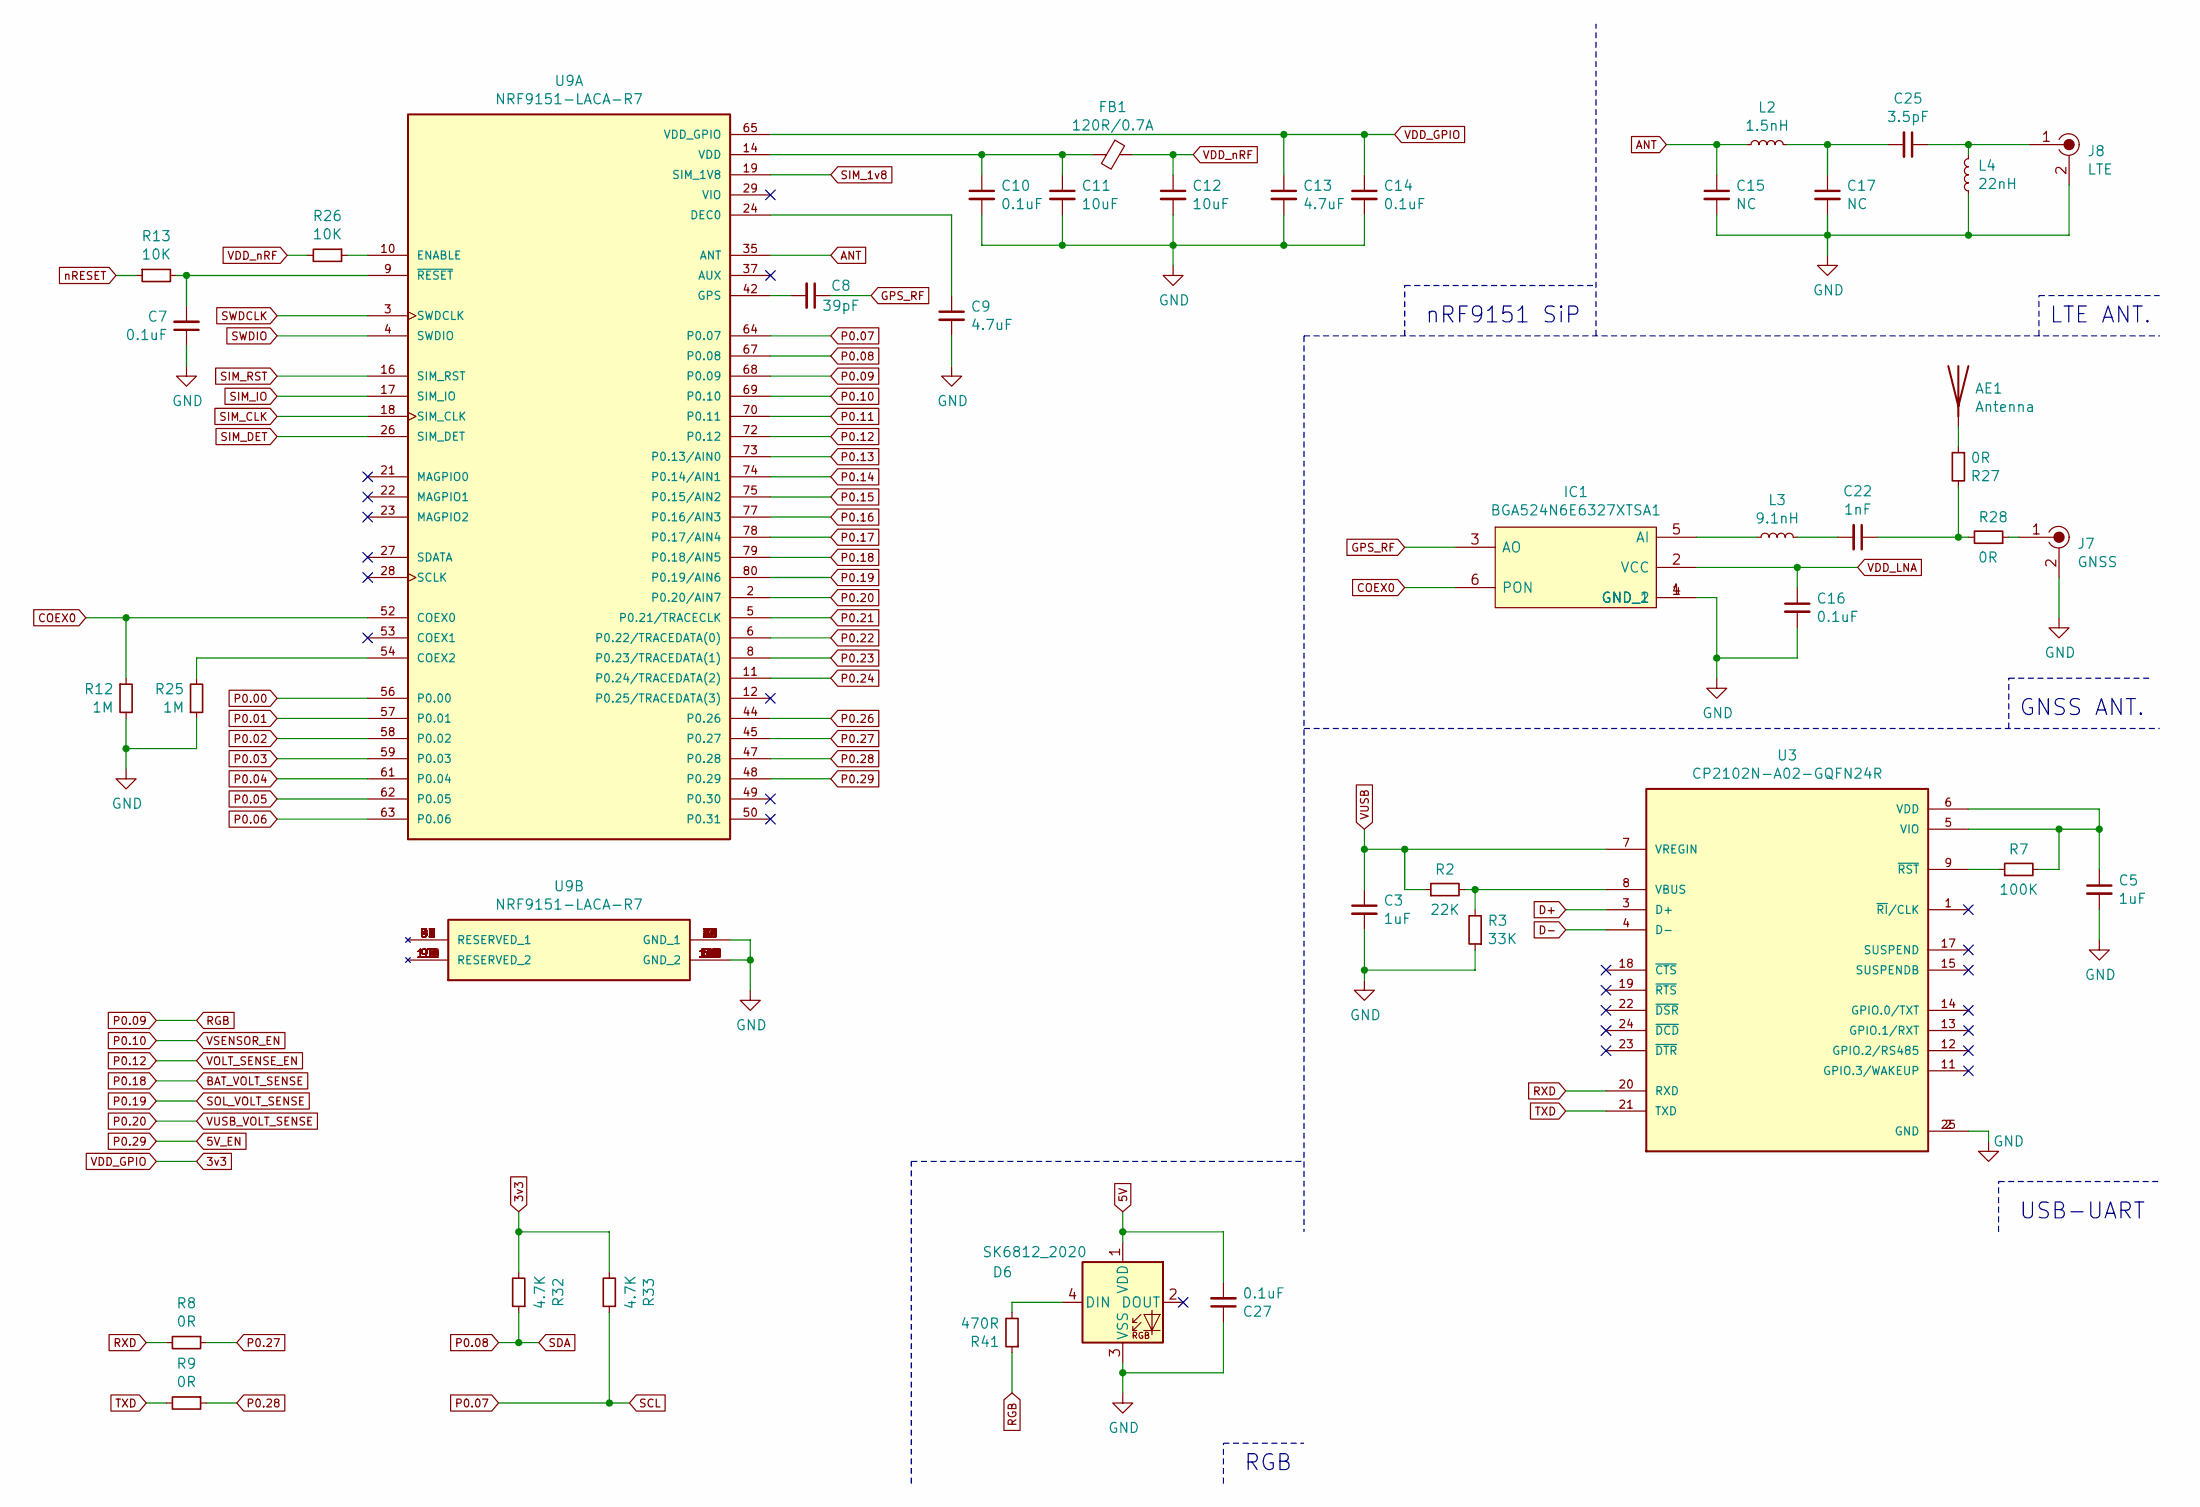
[picture p18: schematic nRF9151_MCU.kicad_sch]

Parts:
AE1: Antenna; YG0005AA
C3, C5: 1uF; C_0402_1005Metric
C7, C10, C14, C16, C27: 0.1uF; C_0402_1005Metric
C8: 39pF; C_0402_1005Metric
C9, C13: 4.7uF; C_0402_1005Metric
C11, C12: 10uF; C_0603_1608Metric
C15, C17: NC; C_0402_1005Metric
C22: 1nF; C_0402_1005Metric
C25: 3.5pF; C_0402_1005Metric
D6: SK6812_2020
FB1: 120R/0.7A; R_0603_1608Metric_Pad0.98x0.95mm_HandSolder
IC1: BGA524N6E6327XTSA1; Manufacturer_Part_Number BGA524N6E6327XTSA1; Mouser Part Number 726-A524N6E6327XTSA1
J7: GNSS; U.FL-R-SMT-1; MPN U.FL-R-SMT(10); Digi-Key_PN H9161CT-ND
J8: LTE; U.FL-R-SMT-1; MPN U.FL-R-SMT(10); Digi-Key_PN H9161CT-ND
L2: 1.5nH; L_0402_1005Metric
L3: 9.1nH; L_0402_1005Metric
L4: 22nH; L_0402_1005Metric
R2: 22K; R_0402_1005Metric
R3: 33K; R_0402_1005Metric
R7: 100K; R_0402_1005Metric
R8, R9, R27, R28: 0R; R_0402_1005Metric
R12, R25: 1M; R_0402_1005Metric
R13, R26: 10K; R_0402_1005Metric
R32, R33: 4.7K; R_0402_1005Metric
R41: 470R; R_0402_1005Metric
U3: CP2102N-A02-GQFN24R; PARTREV 1.3
U9: NRF9151-LACA-R7; PARTREV 1.0

Connections:
3v3: C13.1, C14.1, R32.2, R33.2, U9.65 (VDD_GPIO); also elsewhere on the board
5V: C27.2, D6.1 (VDD); also elsewhere on the board
5V_EN: U9.48 (P0.29); also elsewhere on the board
ANT: C15.1, L2.1, U9.35 (ANT)
BAT_VOLT_SENSE: U9.79 (P0.18/AIN5); also elsewhere on the board
COEX0: IC1.6 (PON), R12.1, U9.52 (COEX0)
D+: U3.3 (D+); also elsewhere on the board
D-: U3.4 (D-); also elsewhere on the board
GND: C3.2, C5.2, C7.1, C9.2, C10.2, C11.2, C12.2, C13.2, C14.2, C15.2, C16.2, C17.2, C27.1, D6.3 (VSS), IC1.1 (GND_1), IC1.4 (GND_2), J7.2, J8.2, L4.1, R3.1, R12.2, R25.1, U3.2 (GND), U3.25 (GND), U9.1 (GND_1), U9.7 (GND_1), U9.13 (GND_1), U9.15 (GND_1), U9.20 (GND_1), U9.25 (GND_1), U9.30 (GND_1), U9.34 (GND_1), U9.36 (GND_1), U9.38 (GND_1), U9.39 (GND_1), U9.40 (GND_1), U9.41 (GND_1), U9.43 (GND_1), U9.46 (GND_1), U9.51 (GND_2), U9.55 (GND_2), U9.60 (GND_2), U9.66 (GND_2), U9.71 (GND_2), U9.76 (GND_2), U9.105 (GND_2), U9.106 (GND_2), U9.107 (GND_2), U9.108 (GND_2), U9.109 (GND_2), U9.110 (GND_2), U9.111 (GND_2), U9.112 (GND_2), U9.113 (GND_2); also elsewhere on the board
GPS_RF: C8.1, IC1.3 (AO)
unnamed: AE1.1 (A), R27.1
unnamed: C17.1, C25.2, L2.2
unnamed: C22.1, R27.2, R28.2
unnamed: C22.2, L3.2
unnamed: C25.1, J8.1, L4.2
unnamed: D6.4 (DIN), R41.2
unnamed: IC1.5 (AI), L3.1
unnamed: J7.1, R28.1
unnamed: R2.2, R3.2, U3.8 (VBUS)
unnamed: C5.1, R7.2, U3.5 (VIO), U3.6 (VDD)
unnamed: R7.1, U3.9 (~RST)
unnamed: R25.2, U9.54 (COEX2)
unnamed: C9.1, U9.24 (DEC0)
unnamed: R26.1, U9.10 (ENABLE)
unnamed: C8.2, U9.42 (GPS)
unnamed: C10.1, C11.1, FB1.2, U9.14 (VDD)
unnamed: C7.2, R13.2, U9.9 (~RESET)
P0.00: U9.56 (P0.00); also elsewhere on the board
P0.01: U9.57 (P0.01); also elsewhere on the board
P0.02: U9.58 (P0.02); also elsewhere on the board
P0.03: U9.59 (P0.03); also elsewhere on the board
P0.04: U9.61 (P0.04); also elsewhere on the board
P0.05: U9.62 (P0.05); also elsewhere on the board
P0.06: U9.63 (P0.06); also elsewhere on the board
P0.07: R33.1, U9.64 (P0.07); also elsewhere on the board
P0.08: R32.1, U9.67 (P0.08); also elsewhere on the board
P0.09: R41.1, U9.68 (P0.09)
P0.10: U9.69 (P0.10); also elsewhere on the board
P0.11: U9.70 (P0.11); also elsewhere on the board
P0.12: U9.72 (P0.12); also elsewhere on the board
P0.13: U9.73 (P0.13/AIN0); also elsewhere on the board
P0.14: U9.74 (P0.14/AIN1); also elsewhere on the board
P0.15: U9.75 (P0.15/AIN2); also elsewhere on the board
P0.16: U9.77 (P0.16/AIN3); also elsewhere on the board
P0.17: U9.78 (P0.17/AIN4); also elsewhere on the board
P0.19: U9.80 (P0.19/AIN6); also elsewhere on the board
P0.20: U9.2 (P0.20/AIN7); also elsewhere on the board
P0.21: U9.5 (P0.21/TRACECLK); also elsewhere on the board
P0.22: U9.6 (P0.22/TRACEDATA(0)); also elsewhere on the board
P0.23: U9.8 (P0.23/TRACEDATA(1)); also elsewhere on the board
P0.24: U9.11 (P0.24/TRACEDATA(2)); also elsewhere on the board
P0.26: U9.44 (P0.26)
P0.27: R8.1, U9.45 (P0.27); also elsewhere on the board
P0.28: R9.1, U9.47 (P0.28); also elsewhere on the board
RXD: R8.2, U3.20 (RXD)
SIM_1v8: U9.19 (SIM_1V8); also elsewhere on the board
SIM_CLK: U9.18 (SIM_CLK); also elsewhere on the board
SIM_DET: U9.26 (SIM_DET); also elsewhere on the board
SIM_IO: U9.17 (SIM_IO); also elsewhere on the board
SIM_RST: U9.16 (SIM_RST); also elsewhere on the board
SWDCLK: U9.3 (SWDCLK); also elsewhere on the board
SWDIO: U9.4 (SWDIO); also elsewhere on the board
TXD: R9.2, U3.21 (TXD)
VDD_LNA: C16.1, IC1.2 (VCC); also elsewhere on the board
VDD_nRF: C12.1, FB1.1, R26.2; also elsewhere on the board
VUSB: C3.1, R2.1, U3.7 (VREGIN); also elsewhere on the board
nRESET: R13.1; also elsewhere on the board

Notes on the sheet:
nRF9151 SiP
GNSS ANT.
RGB
USB-UART
LTE ANT.

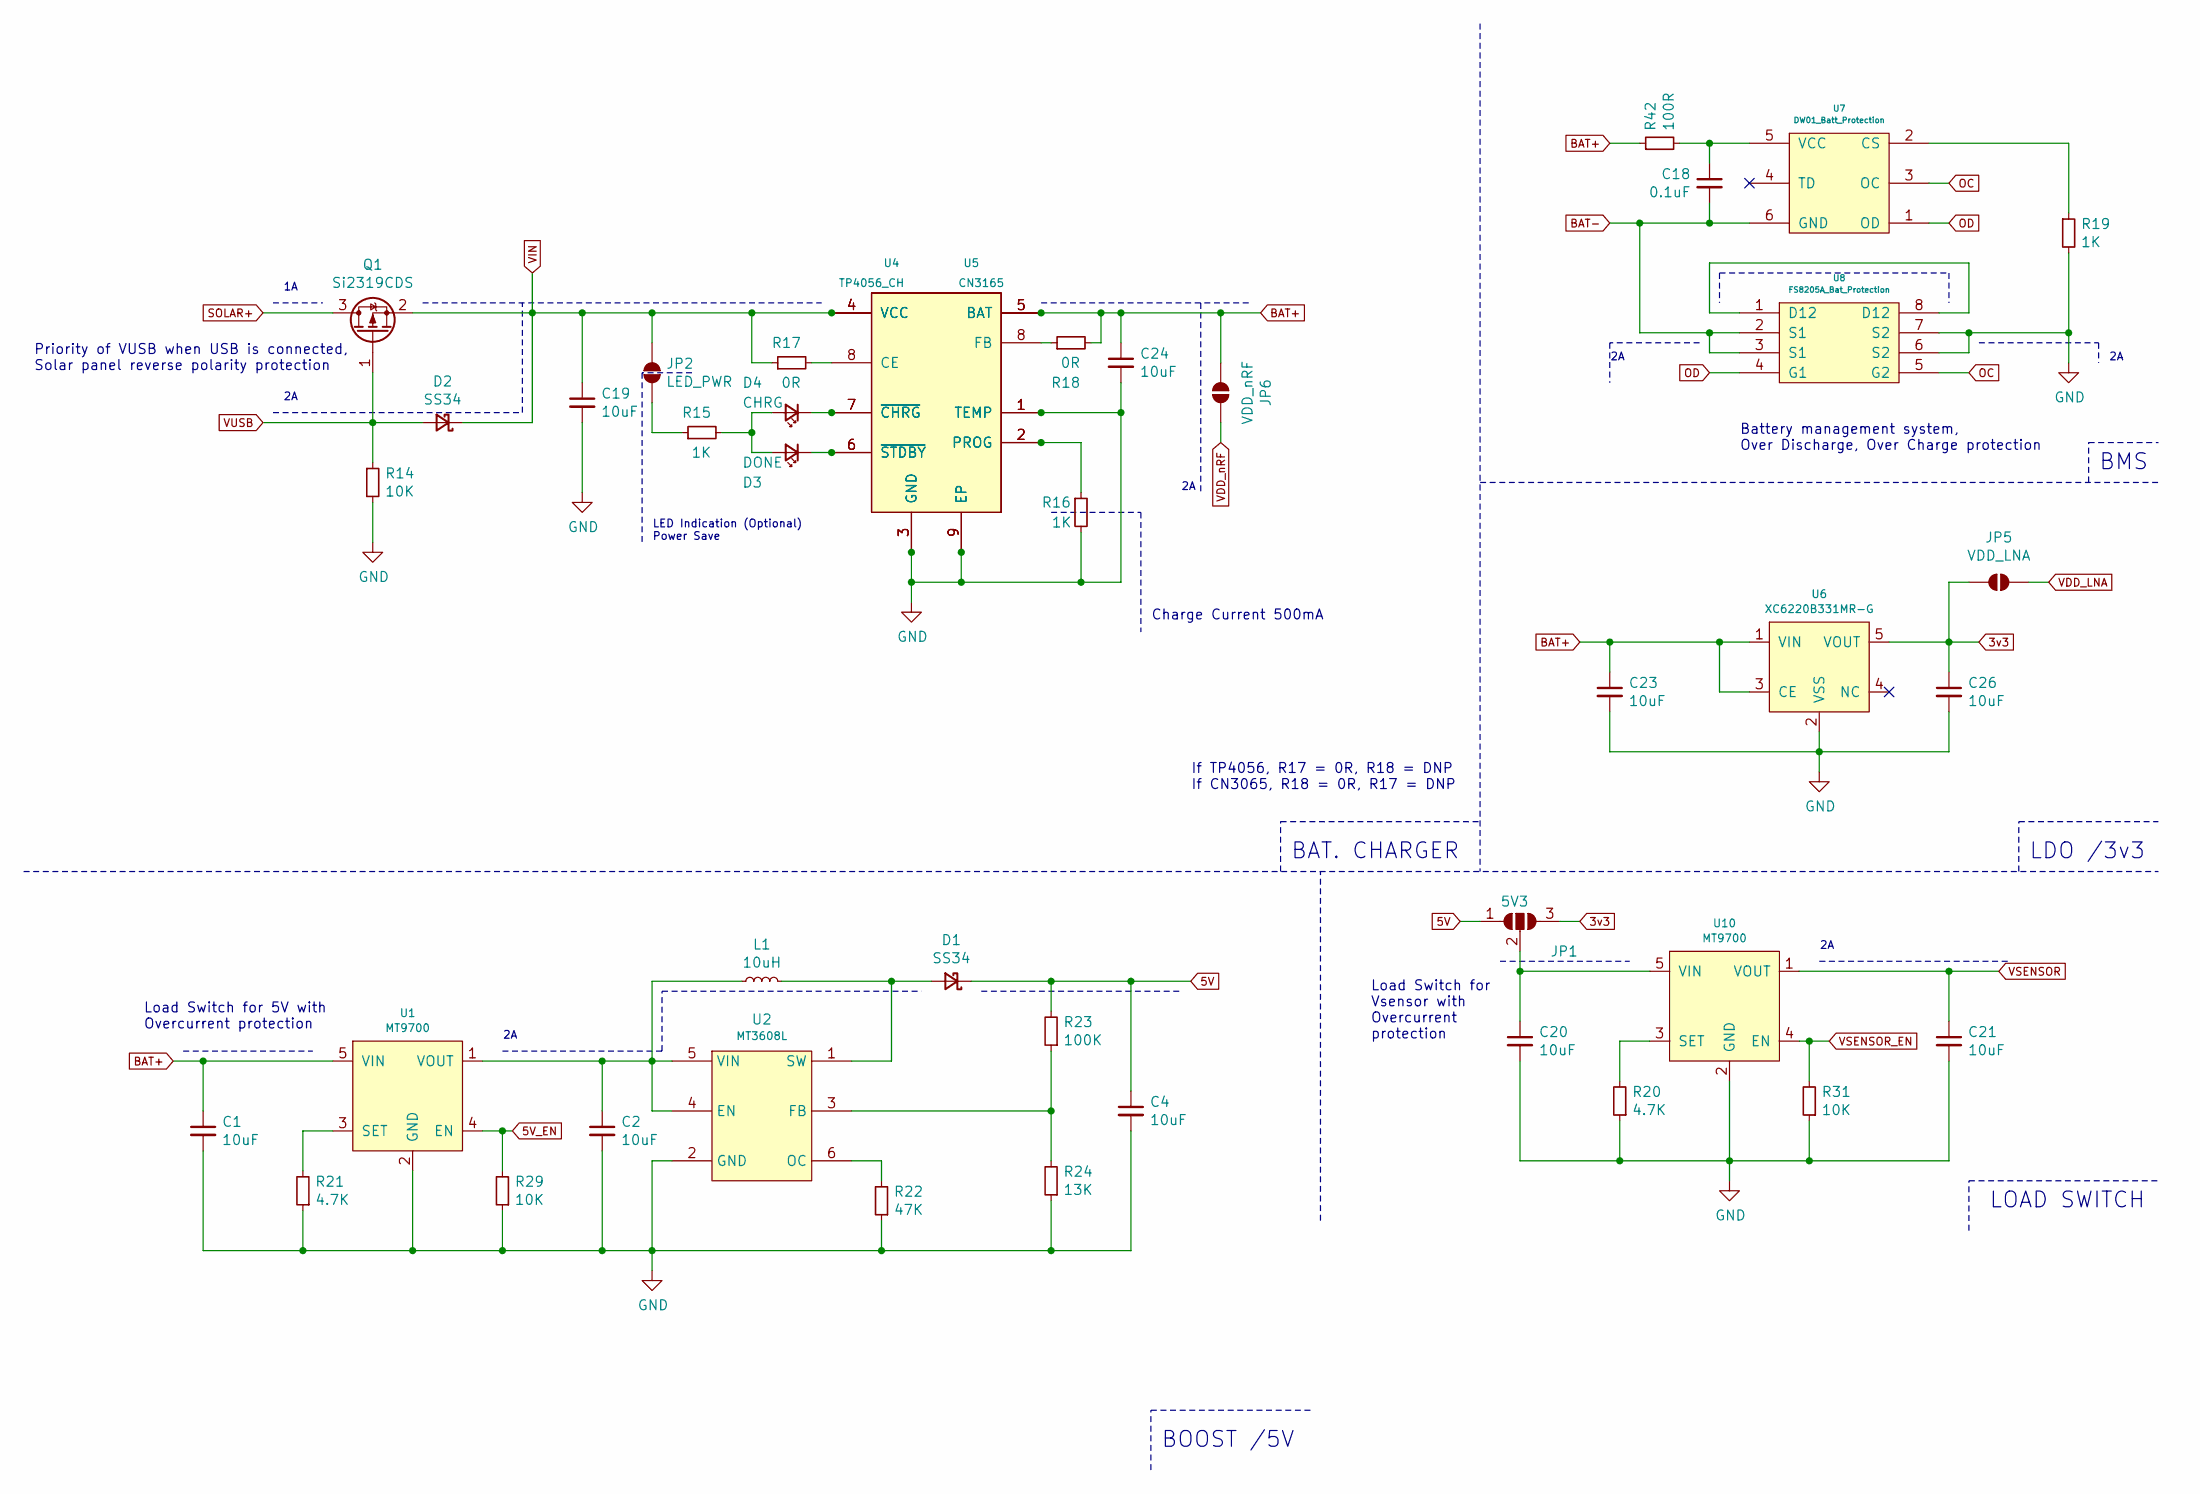
[picture p19: schematic Power.kicad_sch]

Parts:
C1, C2, C4, C19, C20, C21, C23, C24, C26: 10uF; C_0603_1608Metric
C18: 0.1uF; C_0402_1005Metric
D1, D2: SS34; D_SOD-123F
D3: DONE; LED_0603_1608Metric
D4: CHRG; LED_0603_1608Metric
JP1: 5V3; SolderJumper-3_P1.3mm_Open_RoundedPad1.0x1.5mm
JP2: LED_PWR; SolderJumper-2_P1.3mm_Open_RoundedPad1.0x1.5mm
JP5: VDD_LNA; SolderJumper-2_P1.3mm_Open_RoundedPad1.0x1.5mm
JP6: VDD_nRF; SolderJumper-2_P1.3mm_Open_RoundedPad1.0x1.5mm
L1: 10uH; Inductor_GPSR0520_HCM1A4020V2_1R0
Q1: Si2319CDS; SOT-23
R14, R29, R31: 10K; R_0402_1005Metric
R15, R16, R19: 1K; R_0402_1005Metric
R17, R18: 0R; R_0402_1005Metric
R20, R21: 4.7K; R_0402_1005Metric
R22: 47K; R_0402_1005Metric
R23: 100K; R_0402_1005Metric
R24: 13K; R_0402_1005Metric
R42: 100R; R_0402_1005Metric
U1, U10: MT9700; SOT-23-5
U2: MT3608L; SOT-23-6
U4: TP4056_CH; SOP-8
U5: CN3165; DFN-8-1EP_3x3mm_P0.5mm_EP1.66x2.38mm
U6: XC6220B331MR-G; SOT-23-5
U7: DW01_Batt_Protection; SOT-23-6
U8: FS8205A_Bat_Protection; TSSOP-8_4.4x3mm_P0.65mm

Connections:
3v3: C26.1, JP1.3 (B), JP5.1 (A), U6.5 (VOUT); also elsewhere on the board
5V: C4.1, D1.1 (K), JP1.1 (A), R23.2; also elsewhere on the board
5V_EN: R29.2, U1.4 (EN); also elsewhere on the board
BAT+: C1.1, C23.1, C24.1, JP6.2 (B), R18.2, R42.1, U1.5 (VIN), U4.5 (BAT), U5.5 (BAT), U6.1 (VIN), U6.3 (CE); also elsewhere on the board
BAT-: C18.2, U7.6 (GND), U8.2 (S1), U8.3 (S1); also elsewhere on the board
GND: C1.2, C2.2, C4.2, C19.2, C20.2, C21.2, C23.2, C24.2, C26.2, R14.2, R16.2, R19.2, R20.1, R21.1, R22.1, R24.1, R29.1, R31.1, U1.2 (GND), U2.2 (GND), U4.1 (TEMP), U4.3 (GND), U4.9 (EP), U5.1 (TEMP), U5.3 (GND), U5.9 (EP), U6.2 (VSS), U8.6 (S2), U8.7 (S2), U10.2 (GND); also elsewhere on the board
unnamed: D1.2 (A), L1.2, U2.1 (SW)
unnamed: D3.2 (A), D4.2 (A), R15.2
unnamed: D3.1 (K), U4.6 (~STDBY), U5.6 (~STDBY)
unnamed: D4.1 (K), U4.7 (~CHRG), U5.7 (~CHRG)
unnamed: C20.1, JP1.2 (C), U10.5 (VIN)
unnamed: JP2.2 (B), R15.1
unnamed: R21.2, U1.3 (SET)
unnamed: C2.1, L1.1, U1.1 (VOUT), U2.4 (EN), U2.5 (VIN)
unnamed: R23.1, R24.2, U2.3 (FB)
unnamed: R22.2, U2.6 (OC)
unnamed: R17.2, U4.8 (CE)
unnamed: R16.1, U4.2 (PROG), U5.2 (PROG)
unnamed: R18.1, U5.8 (FB)
unnamed: R19.1, U7.2 (CS)
unnamed: C18.1, R42.2, U7.5 (VCC)
unnamed: U8.1 (D12), U8.8 (D12)
unnamed: R20.2, U10.3 (SET)
OC: U7.3 (OC), U8.5 (G2)
OD: U7.1 (OD), U8.4 (G1)
P0.10: R31.2, U10.4 (EN); also elsewhere on the board
SOLAR+: Q1.3 (D); also elsewhere on the board
VDD_LNA: JP5.2 (B); also elsewhere on the board
VDD_nRF: JP6.1 (A); also elsewhere on the board
VIN: C19.1, D2.1 (K), JP2.1 (A), Q1.2 (S), R17.1, U4.4 (VCC), U5.4 (VCC); also elsewhere on the board
VSENSOR: C21.1, U10.1 (VOUT); also elsewhere on the board
VUSB: D2.2 (A), Q1.1 (G), R14.1; also elsewhere on the board

Notes on the sheet:
Charge Current 500mA
Load Switch for 5V with Overcurrent protection
LOAD SWITCH
BAT. CHARGER
If TP4056, R17 = 0R, R18 = DNP If CN3065, R18 = 0R, R17 = DNP
Priority of VUSB when USB is connected, Solar panel reverse polarity protection
BMS
LED Indication (Optional) Power Save
LDO /3v3
BOOST /5V
Load Switch for Vsensor with Overcurrent protection
Battery management system, Over Discharge, Over Charge protection

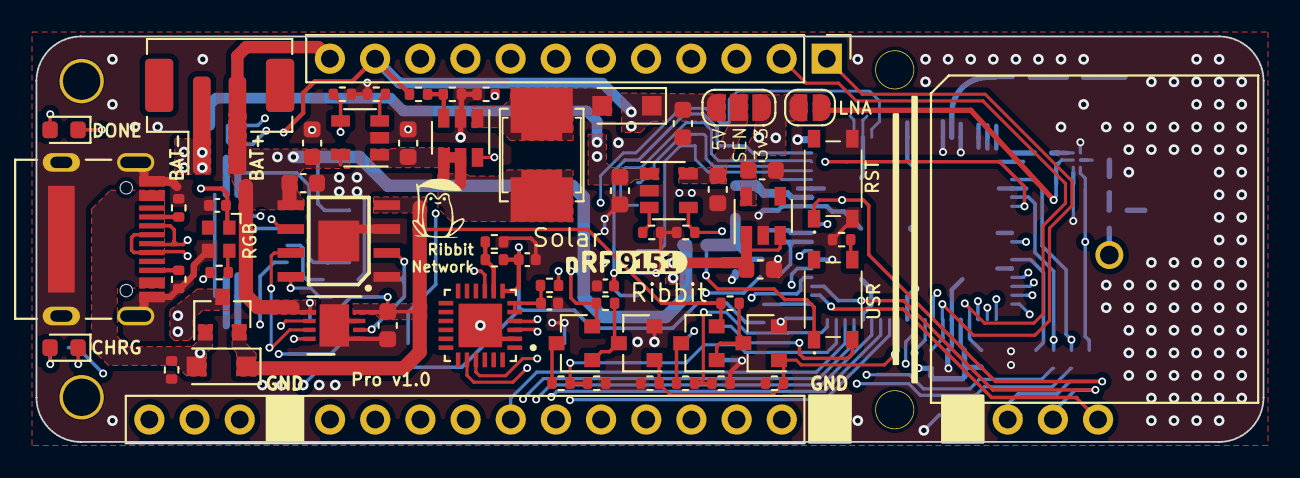
[picture p20: board nRF9151_Linear.kicad_pcb from above]

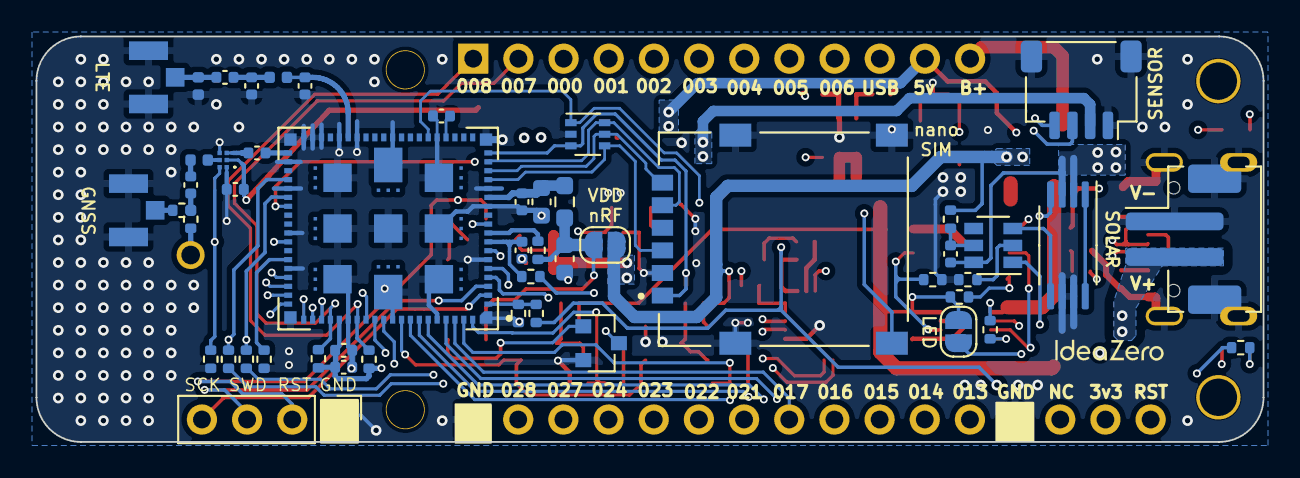
[picture p21: board nRF9151_Linear.kicad_pcb from below]

Board: 4 copper layers, 69.0 x 22.8 mm, 115 parts (51 on the bottom side), 97 nets.

Other parts of the board:
': '; IZ_logo_Small_2
kibuzzard-67CE8F77: G***; kibuzzard-67CE8F77
