IdeaZero/Solar_Ribbit_Pro/Firmware/Firmware/led_strip/src/main.c

/*
 * Copyright (c) 2017 Linaro Limited
 * Copyright (c) 2018 Intel Corporation
 * Copyright (c) 2024 TOKITA Hiroshi
 *
 * SPDX-License-Identifier: Apache-2.0
 */

#include <errno.h>
#include <string.h>

#define LOG_LEVEL 4
#include <zephyr/logging/log.h>
LOG_MODULE_REGISTER(main);

#include <zephyr/kernel.h>
#include <zephyr/drivers/led_strip.h>
#include <zephyr/device.h>
#include <zephyr/drivers/spi.h>
#include <zephyr/sys/util.h>

#include <zephyr/drivers/gpio.h>
#define STRIP_NODE DT_ALIAS(led_strip)

#define LED0_NODE DT_ALIAS(led0)
#define LED1_NODE DT_ALIAS(led1)
static const struct gpio_dt_spec boost_5v = GPIO_DT_SPEC_GET(LED0_NODE, gpios);
static const struct gpio_dt_spec boost_3v3 = GPIO_DT_SPEC_GET(LED1_NODE, gpios);

#if DT_NODE_HAS_PROP(DT_ALIAS(led_strip), chain_length)
#define STRIP_NUM_PIXELS DT_PROP(DT_ALIAS(led_strip), chain_length)
#else
#error Unable to determine length of LED strip
#endif

#define DELAY_TIME K_MSEC(CONFIG_SAMPLE_LED_UPDATE_DELAY)

#define RGB(_r, _g, _b) {.r = (_r), .g = (_g), .b = (_b)}

static const struct led_rgb colors[] = {
	RGB(0x0f, 0x00, 0x00), /* red */
	RGB(0x00, 0x0f, 0x00), /* green */
	RGB(0x00, 0x00, 0x0f), /* blue */
};

static struct led_rgb pixels[STRIP_NUM_PIXELS];

static const struct device *const strip = DEVICE_DT_GET(STRIP_NODE);

int main(void)
{
	size_t color = 0;
	int rc;
	if (!device_is_ready(boost_5v.port))
	{
		LOG_ERR("boost 5v pin not ready");
		// return; // Or handle the error appropriately
	}

	// boost_5v power pin config
	rc = gpio_pin_configure_dt(&boost_5v, GPIO_OUTPUT_ACTIVE);
	if (rc < 0)
	{
		LOG_ERR("Error configuring boost 5v (err %d)", rc);
		// return; // Or handle the error appropriately
	}
	// boost_3v3 power pin config
	if (!device_is_ready(boost_3v3.port))
	{
		LOG_ERR("boost 3v3 pin not ready");
		// return; // Or handle the error appropriately
	}
	rc = gpio_pin_configure_dt(&boost_3v3, GPIO_OUTPUT_ACTIVE);
	if (rc < 0)
	{
		LOG_ERR("Error configuring boost 3v3 (err %d)", rc);
		// return; // Or handle the error appropriately
	}
	gpio_pin_set_dt(&boost_5v, 1);

	gpio_pin_set_dt(&boost_3v3, 1);
	if (device_is_ready(strip))
	{
		LOG_INF("Found LED strip device %s", strip->name);
	}
	else
	{
		LOG_ERR("LED strip device %s is not ready", strip->name);
		return 0;
	}

	LOG_INF("Displaying pattern on strip");
	while (1)
	{
		for (size_t cursor = 0; cursor < ARRAY_SIZE(pixels); cursor++)
		{
			memset(&pixels, 0x00, sizeof(pixels));
			memcpy(&pixels[cursor], &colors[color], sizeof(struct led_rgb));

			rc = led_strip_update_rgb(strip, pixels, STRIP_NUM_PIXELS);
			if (rc)
			{
				LOG_ERR("couldn't update strip: %d", rc);
			}

			k_sleep(DELAY_TIME);
		}

		color = (color + 1) % ARRAY_SIZE(colors);
	}

	return 0;
}
