IdeaZero/Solar_Ribbit_Pro/Firmware/Firmware/gnss/src/mcc_location_table.c

/*
 * Copyright (c) 2021 Nordic Semiconductor ASA
 *
 * SPDX-License-Identifier: LicenseRef-Nordic-5-Clause
 */

#include <zephyr/sys/util.h>

#include "mcc_location_table.h"

/* Float latitude to integer conversion factor (2^23/90) */
#define LAT_CONV (8388608.0f / 90.0f)
/* Float longitude to integer conversion factor (2^24/360) */
#define LON_CONV (16777216.0f / 360.0f)

static const struct mcc_table mcc_table[] = {
	{ 100, 104, 104,   0,   43.00f,   41.01f, 289 }, /* Abkhazia */
	{ 100, 119, 119,   0,   33.84f,   66.00f, 412 }, /* Afghanistan */
	{ 100, 104, 104,   0,   41.14f,   20.05f, 276 }, /* Albania */
	{ 100, 125, 125,   0,   28.16f,    2.62f, 603 }, /* Algeria */
	{ 100, 107, 107,   0,  -14.31f, -170.70f, 544 }, /* American Samoa */
	{ 100,  80,  80,   0,   42.54f,    1.56f, 213 }, /* Andorra */
	{ 100, 121, 121,   0,  -11.21f,   17.88f, 631 }, /* Angola */
	{ 100,  86,  86,   0,   18.22f,  -63.06f, 365 }, /* Anguilla */
	{ 100,  88,  88,   0,   17.28f,  -61.79f, 344 }, /* Antigua and Barbuda */
	{  80, 118, 127,   0,  -35.38f,  -65.18f, 722 }, /* Argentina */
	{ 100, 104, 104,   0,   40.29f,   44.93f, 283 }, /* Armenia */
	{ 100,  78,  78,   0,   12.52f,  -69.96f, 363 }, /* Aruba */
	{  80, 127, 127,   0,  -25.73f,  134.49f, 505 }, /* Australia */
	{ 100, 109, 109,   0,   47.59f,   14.13f, 232 }, /* Austria */
	{ 100, 109, 109,   0,   40.29f,   47.55f, 400 }, /* Azerbaijan */
	{ 100, 110, 113,   0,   24.29f,  -76.63f, 364 }, /* Bahamas */
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
	{ 100, 113, 113,   0,    1.27f,   32.37f, 641 }, /* Uganda */
	{ 100, 119, 119,   0,   49.00f,   31.38f, 255 }, /* Ukraine */
	{ 100, 109, 109,   0,   24.35f,   53.94f, 424 }, /* United Arab Emirates */
	{ 100,  85,  85,   0,   24.47f,   54.37f, 430 }, /* United Arab Emirates (Abu Dhabi) */
	{ 100,  86,  86,   0,   25.07f,   55.17f, 431 }, /* United Arab Emirates (Dubai) */
	{ 100, 119, 119,   0,   54.12f,   -2.87f, 234 }, /* United Kingdom */
	{ 100, 119, 119,   0,   54.12f,   -2.87f, 235 }, /* United Kingdom */
	{  35, 127, 127,   0,   45.68f, -112.46f, 310 }, /* United States of America */
	{  35, 127, 127,   0,   45.68f, -112.46f, 311 }, /* United States of America */
	{  35, 127, 127,   0,   45.68f, -112.46f, 312 }, /* United States of America */
	{  35, 127, 127,   0,   45.68f, -112.46f, 313 }, /* United States of America */
	{  35, 127, 127,   0,   45.68f, -112.46f, 314 }, /* United States of America */
	{  35, 127, 127,   0,   45.68f, -112.46f, 315 }, /* United States of America */
	{  35, 127, 127,   0,   45.68f, -112.46f, 316 }, /* United States of America */
	{ 100,  89,  89,   0,   17.96f,  -64.80f, 332 }, /* United States Virgin Islands */
	{ 100, 111, 111,   0,  -32.80f,  -56.02f, 748 }, /* Uruguay */
	{ 100, 120, 120,   0,   41.76f,   63.14f, 434 }, /* Uzbekistan */
	{ 100, 113, 113,   0,  -16.23f,  167.69f, 541 }, /* Vanuatu */
	{ 100, 122, 122,   0,    7.12f,  -66.18f, 734 }, /* Venezuela */
	{ 100, 120, 120,   0,   16.65f,  106.30f, 452 }, /* Vietnam */
	{ 100, 100, 100,   0,  -13.89f, -177.35f, 543 }, /* Wallis and Futuna */
	{ 100, 118, 118,   0,   15.91f,   47.59f, 421 }, /* Yemen */
	{ 100, 119, 119,   0,  -13.46f,   27.77f, 645 }, /* Zambia */
	{ 100, 115, 115,   0,  -19.00f,   29.85f, 648 }, /* Zimbabwe */
};

const struct mcc_table *mcc_lookup(uint16_t mcc)
{
	for (int i = 0; i < ARRAY_SIZE(mcc_table); i++) {
		if (mcc_table[i].mcc == mcc) {
			return &mcc_table[i];
		}
	}

	return NULL;
}

int32_t lat_convert(float lat)
{
	return (int32_t)(lat * LAT_CONV);
}

int32_t lon_convert(float lon)
{
	return (int32_t)(lon * LON_CONV);
}
