IdeaZero/Solar_Ribbit_Pro/Firmware/Firmware/gnss/src/factory_almanac_v3.h

/*
 * Copyright (c) 2023 Nordic Semiconductor ASA
 *
 * SPDX-License-Identifier: LicenseRef-Nordic-5-Clause
 */

#ifndef FACTORY_ALMANAC_V3_H_
#define FACTORY_ALMANAC_V3_H_

/* Factory almanac generated on 2024-11-02 19:21:00.
 *
 * Note, that the almanac gets more inaccurate with time and it should be updated periodically.
 */

#define FACTORY_ALMANAC_DATA_V3 \
	"f0ea030031230900000000000000000000000000000000000000000000000000" \
	"0000000000000000000031d085242309c90f3dfd00140da100b18cd9ffbfe4d2" \
	"ff1e7193ffaefe0200316b2e242309161d73fd00c50ca10014e30700805a2f00" \
	"373004006b02030031ae19242309260f5ffd001c0da1005ac233004b8e85ff3c" \
	"0181fff101020031ea2e2423098c1468fd003f0da100fbb50500647e3600f768" \
	"9aff37ff0000315b1a2423099c1e4ffd00720da100c4b3ddffb2ace0ff442040" \
	"00a2fff8ff31239a2423090e054afd003f0ca100ac005d008d9faaff4bea1b00" \
	"e9ff0100310c5124230949053dfd003f0da10067cdb0ffab430f00c7ea8dffa8" \
	"01030031271a242309160b5bfd001d0ca1006148310098ee510098f5a2ffc201" \
	"0500313351242309d91c75fd002f0da100a1c8070045959fffc6b7ddff40fffc" \
	"ff313d0e242309640f3bfd00270ca1003be7deffcd0b9dfffd876900effcffff" \
	"312e48242309a10c68fd00390ca10075758affeab23b00fec1feffbffdffff31" \
	"a3472423093d135ffd00130da100be243800c9ae270065e280ffce02000031c9" \
	"28242309c30157fd00310da100b18b88ffe6978bff638bf8ff2f020200315f84" \
	"2423093afc47fd004c0da100f6e62b00e301380023836400eb00010031137424" \
	"23093b0c68fd00ce0ca100b12d8bfff3a8220092c5b5ff70ff030031f46e2423" \
	"098a0f4afd00300ca10034c4b4ffd9f9cbff28ee8aff5702fcff314127242309" \
	"c01443fd00720da1005fc6ddff4b7687ff575d3b004cfd000031bd5124230903" \
	"0f47fd009e0da100d291b6ff0ef26c00a79dd7ff4a020100318d1f2423090609" \
	"54fd00ae0ca100e359000089029bff67d74c008301000031fdd0242309080c38" \
	"fd00b50ca100a837d9ffdbb8ebff35d685ff67000000319071242309ce0b67fd" \
	"00200da10007508bff186ed3ff1efca0ffafffffff31fc27242309ac196efd00" \
	"a70ca10054920600e33189fff9420d007601020031118524230969fa39fd0002" \
	"0da1000aef58000ad72900bc73400007fe0000314f62242309d9045dfd00520d" \
	"a1000cdc86ff3fa72c00a37df7ff0b02000031d44d2423094ff84bfd005c0da1" \
	"004c3184ffa2581700eecfd8ff2700fdff31b1682423092b0b43fd00180da100" \
	"2af0b1ff338b2000874290ffdcff000031dc03242309410c54fd00820da100d1" \
	"ba5b002b6f390002afebff15fefdff318017242309281149fd00a30da1002b65" \
	"b5ff09276d00217d89ffaefd0100317c3a24230962fb3cfd00ba0da100f8ed5c" \
	"00b5ae9bfff05f1600d1fe020031b957242309a1074efd00350ca1002fe85d00" \
	"8f2a1f006ba0f0ff17ff00003172412423093f0d5dfd00890da1008be7310023" \
	"0ea9fffdf3a9ffa2fd0100000000000000000000000000000000000000000000" \
	"00000000000000000000000000003175851523098dcb53ff0112e7ca00fba394" \
	"ff7e72bfffcb200e000000000031e17b1523091ecc27ff0188ecca007849dbff" \
	"8a3ac0ffad12c7fffaff00003142781523090e9c1bff0131eaca003e7c200066" \
	"90c0ff733b7f0017000000000000000000000000000000000000000000000000" \
	"0000000000000000000000000000000000000000000000000000000000000000" \
	"00000000000000000031e701152309b4005a0001c4ebca002eea4a00721b3200" \
	"c2dddcff00000000000000000000000000000000000000000000000000000000" \
	"0000000000000000000000000000000000000000000000000000000000000000" \
	"0000000000000000000000000000000000000000000000000000000000000000" \
	"00000000000000000000000000000000000000000000000000000000000000"
#define FACTORY_ALMANAC_CHECKSUM_V3 \
	"9a0e8178694895b8ee7c04dcab3c1041f6e98fee091d60d06ffb826069491182"

#endif /* FACTORY_ALMANAC_V3_H_ */
