IdeaZero/Solar_Ribbit_Pro/(commit log)

2025-05-09 Getting started
    [Interfaces.kicad_sch, Interfaces.sch, Peripherals.sch, Power.kicad_sch, Power.sch, V4_Holder_3.STL, nRF9151_Linear.kicad_pcb, nRF9151_Linear.kicad_pcb_bom.xlsx]
2025-05-10 I2C Scan updated
